Greyd0ve/nuedc_21f_car_mspm0/tmp/pdfs/ir8-pin-audit/schematic-3.png

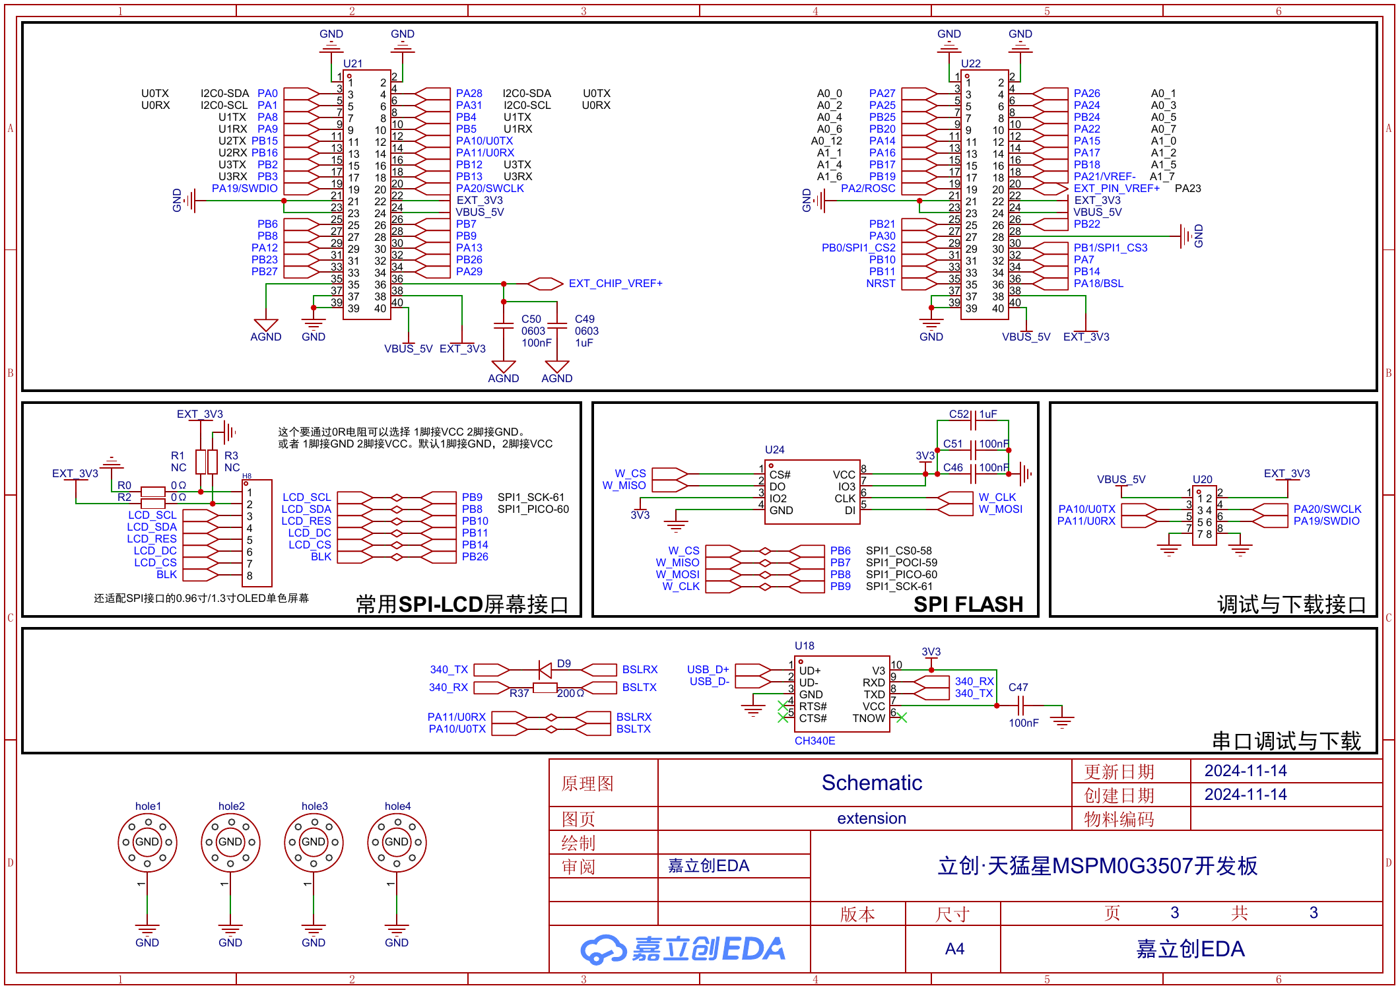
tmp/pdfs/ir8-pin-audit/schematic-3.png
