Greyd0ve/nuedc_21f_car_mspm0/firmware_withoutK230/master_car/keil/build_output.txt

Clean started: Project: 'empty_LP_MSPM0G3507_nortos_keil'
   deleting intermediate output files for target 'master_car_withoutK230'
Clean done
Build started: Project: empty_LP_MSPM0G3507_nortos_keil
*** Using Compiler 'V6.21', folder: 'D:\Keil_v5_38a\ARM\ARMCLANG\Bin'
Build target 'master_car_withoutK230'
Before Build - User command #1: cmd.exe /C ""C:\ti\sysconfig_1.21.1\sysconfig_cli.bat" -o "C:\Users\zch20\Desktop\Myproject\Github�ֿ�\nuedc_21f_car_mspm0\firmware_withoutK230\master_car\keil\.." -s "D:\ti2\mspm0_sdk_2_02_00_05\.metadata\product.json" --compiler keil "C:\Users\zch20\Desktop\Myproject\Github�ֿ�\nuedc_21f_car_mspm0\firmware_withoutK230\master_car\keil\..\empty.syscfg""
Running script...
Validating...
info: PWM_SERVO(/ti/driverlib/PWM): Peripheral does not retain register contents in STOP or STANDBY modes. User should take care to save and restore register configuration in application. See Retention Configuration section for more details.
info: TIMER_SYS(/ti/driverlib/TIMER): Peripheral does not retain register contents in STOP or STANDBY modes. User should take care to save and restore register configuration in application. See Retention Configuration section for more details.
Generating Code (empty.syscfg)...
Unchanged C:\Users\zch20\Desktop\Myproject\Github仓库\nuedc_21f_car_mspm0\firmware_withoutK230\master_car\ti_msp_dl_config.c...
Unchanged C:\Users\zch20\Desktop\Myproject\Github仓库\nuedc_21f_car_mspm0\firmware_withoutK230\master_car\ti_msp_dl_config.h...
Unchanged C:\Users\zch20\Desktop\Myproject\Github仓库\nuedc_21f_car_mspm0\firmware_withoutK230\master_car\Event.dot...
compiling app_task_mode.c...
compiling app_line.c...
compiling pid.c...
assembling startup_mspm0g350x_uvision.s...
compiling app_radio.c...
compiling app_control.c...
compiling app_car_base.c...
compiling main.c...
compiling Motor.c...
compiling app_car_state.c...
compiling PWM.c...
compiling app_board_test.c...
compiling Encoder.c...
compiling ti_msp_dl_config.c...
compiling app_21f_car.c...
compiling Key.c...
compiling Grayscale.c...
compiling app_coop.c...
compiling DebugSerial.c...
compiling Serial.c...
compiling Servo.c...
compiling BeepLed.c...
compiling OLED.c...
compiling StepperEncoder.c...
compiling JY61P.c...
compiling NRF24L01.c...
compiling Timer.c...
linking...
Program Size: Code=18916 RO-data=1372 RW-data=16 ZI-data=3216  
FromELF: creating hex file...
".\Objects\master_car_withoutK230.axf" - 0 Error(s), 0 Warning(s).
Build Time Elapsed:  00:00:02
