Greyd0ve/nuedc_21f_car_mspm0/tmp/pdfs/h_problem_3.png

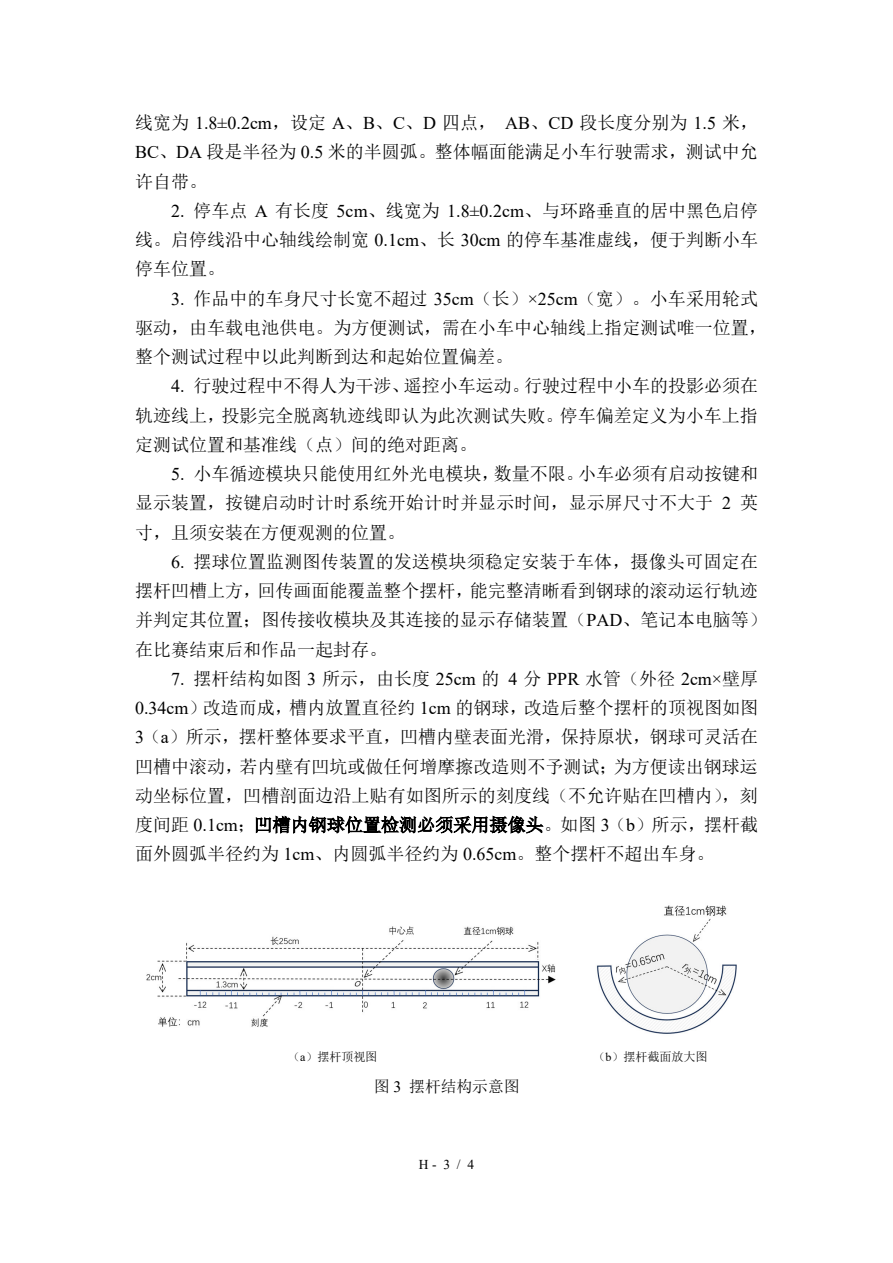
tmp/pdfs/h_problem_3.png
