Greyd0ve/nuedc_21f_car_mspm0/firmware_withK230/master_car/Hardware/Board_Config.h

#ifndef __BOARD_CONFIG_H
#define __BOARD_CONFIG_H

#include "ti_msp_dl_config.h"

/*
 * Board pin map for the MSPM0G3507 car wiring.
 *
 * Keep application code using these names.  SysConfig-generated names stay
 * below this file and can be changed without touching App/Control logic.
 */

/*
 * ECAR_REAR_LINE_SENSOR_MODE:
 *   0 = original front sensor module layout;
 *   1 = rear-facing sensor/camera layout.  The camera view defines the new
 *       vehicle front, so the vehicle coordinate frame is rotated 180 deg.
 *       Original right wheel becomes logical left wheel and original left
 *       wheel becomes logical right wheel; positive logical wheel speed
 *       drives the vehicle toward the camera-view forward direction.
 */
#ifndef ECAR_REAR_LINE_SENSOR_MODE
#define ECAR_REAR_LINE_SENSOR_MODE 1U
#endif

/*
 * The eight-channel infrared module is mounted in front of the drive-wheel
 * axle.  This setting affects only infrared channel order and line-control
 * sign; it deliberately does not alter the verified motor/encoder mapping
 * selected by ECAR_REAR_LINE_SENSOR_MODE above.
 */
#ifndef ECAR_LINE_SENSOR_FORWARD_MOUNT
#define ECAR_LINE_SENSOR_FORWARD_MOUNT 1U
#endif

/* Compatibility aliases for SysConfig-generated grouped GPIO names. */
#if !defined(GPIO_I2C0_SCL_PORT) && defined(GPIO_I2C_SHARED_SCL_PORT)
#define GPIO_I2C0_SCL_PORT              GPIO_I2C_SHARED_SCL_PORT
#define GPIO_I2C0_SCL_PIN               GPIO_I2C_SHARED_SCL_PIN
#define GPIO_I2C0_SDA_PORT              GPIO_I2C_SHARED_SDA_PORT
#define GPIO_I2C0_SDA_PIN               GPIO_I2C_SHARED_SDA_PIN
#endif

#if !defined(GPIO_IR8_X1_PORT) && defined(GPIO_IR8_PORT)
#define GPIO_IR8_X1_PORT                GPIO_IR8_PORT
#define GPIO_IR8_X2_PORT                GPIO_IR8_PORT
#define GPIO_IR8_X3_PORT                GPIO_IR8_PORT
#define GPIO_IR8_X4_PORT                GPIO_IR8_PORT
#define GPIO_IR8_X5_PORT                GPIO_IR8_PORT
#define GPIO_IR8_X6_PORT                GPIO_IR8_PORT
#define GPIO_IR8_X7_PORT                GPIO_IR8_PORT
#define GPIO_IR8_X8_PORT                GPIO_IR8_PORT
#endif

#if !defined(GPIO_KEYS_KEY1_PORT) && defined(GPIO_KEYS_PORT)
#define GPIO_KEYS_KEY1_PORT             GPIO_KEYS_PORT
#define GPIO_KEYS_KEY2_PORT             GPIO_KEYS_PORT
#define GPIO_KEYS_KEY3_PORT             GPIO_KEYS_PORT
#define GPIO_KEYS_KEY4_PORT             GPIO_KEYS_PORT
#endif

#if !defined(GPIO_BEEP_PORT)
#if defined(GPIO_BOARD_IO_BEEP_PORT)
#define GPIO_BEEP_PORT                  GPIO_BOARD_IO_BEEP_PORT
#elif defined(GPIO_BOARD_IO_PORT)
#define GPIO_BEEP_PORT                  GPIO_BOARD_IO_PORT
#endif
#endif

#if !defined(GPIO_BEEP_PIN) && defined(GPIO_BOARD_IO_BEEP_PIN)
#define GPIO_BEEP_PIN                   GPIO_BOARD_IO_BEEP_PIN
#endif

#if !defined(GPIO_BEEP_IOMUX) && defined(GPIO_BOARD_IO_BEEP_IOMUX)
#define GPIO_BEEP_IOMUX                 GPIO_BOARD_IO_BEEP_IOMUX
#endif

#if !defined(GPIO_ENCODER_L_A_PORT) && defined(GPIO_ENCODER_PORT)
#define GPIO_ENCODER_L_A_PORT           GPIO_ENCODER_PORT
#define GPIO_ENCODER_L_B_PORT           GPIO_ENCODER_PORT
#define GPIO_ENCODER_R_A_PORT           GPIO_ENCODER_PORT
#define GPIO_ENCODER_R_B_PORT           GPIO_ENCODER_PORT
#endif

#if !defined(GPIO_ENCODER_INT_IRQN) && defined(GPIO_ENCODER_GPIOA_INT_IRQN)
#define GPIO_ENCODER_INT_IRQN           GPIO_ENCODER_GPIOA_INT_IRQN
#elif !defined(GPIO_ENCODER_INT_IRQN) && defined(GPIO_ENCODER_GPIOB_INT_IRQN)
#define GPIO_ENCODER_INT_IRQN           GPIO_ENCODER_GPIOB_INT_IRQN
#endif

/* Project hardware abstraction: encoder interrupt IRQ number.
 * Encoder.c must use ECAR_ENCODER_IRQN, never a raw SysConfig macro. */
#ifdef GPIO_ENCODER_INT_IRQN
#define ECAR_ENCODER_IRQN               GPIO_ENCODER_INT_IRQN
#else
#error "GPIO_ENCODER_INT_IRQN not generated by SysConfig. Check empty.syscfg encoder GPIO interruptEn setting."
#endif

/* ---------------- TB6612 motor driver ----------------
 * PWMA -> TIMG0-C0, PWMB -> TIMG0-C1.
 * STBY is tied to 5V on the current PCB.  There is no MCU STBY control.
 */
#define MOTOR_USE_STBY                  0U
#define MOTOR_STBY_TIED_TO_5V           1U
#define MOTOR_PWM_TIMER_INST            PWM_MOTOR_INST

#if ECAR_REAR_LINE_SENSOR_MODE

/* Rear sensor / reversed heading mode:
 * original right wheel is logical left wheel;
 * original left wheel is logical right wheel.
 */
#define MOTOR_L_PWM_CC_INDEX            GPIO_PWM_MOTOR_C1_IDX
#define MOTOR_R_PWM_CC_INDEX            GPIO_PWM_MOTOR_C0_IDX

#define MOTOR_L_IN1_PORT                GPIO_MOTOR_R_IN1_PORT   /* PA16 */
#define MOTOR_L_IN1_PIN                 GPIO_MOTOR_R_IN1_PIN
#define MOTOR_L_IN1                     MOTOR_L_IN1_PIN
#define MOTOR_L_IN2_PORT                GPIO_MOTOR_R_IN2_PORT   /* B24 */
#define MOTOR_L_IN2_PIN                 GPIO_MOTOR_R_IN2_PIN
#define MOTOR_L_IN2                     MOTOR_L_IN2_PIN
#define MOTOR_R_IN1_PORT                GPIO_MOTOR_L_IN1_PORT   /* B17 */
#define MOTOR_R_IN1_PIN                 GPIO_MOTOR_L_IN1_PIN
#define MOTOR_R_IN1                     MOTOR_R_IN1_PIN
#define MOTOR_R_IN2_PORT                GPIO_MOTOR_L_IN2_PORT   /* B19 */
#define MOTOR_R_IN2_PIN                 GPIO_MOTOR_L_IN2_PIN
#define MOTOR_R_IN2                     MOTOR_R_IN2_PIN

/*
 * The wheel test showed that the old signs made positive logical PWM drive
 * both wheels backward.  These signs make Motor_SetPWM(+150, +150) drive
 * toward the camera-view forward direction.
 */
#define LEFT_MOTOR_DIR                  (+1)
#define RIGHT_MOTOR_DIR                 (-1)

#else

/* Original front sensor mode. */
#define MOTOR_L_PWM_CC_INDEX            GPIO_PWM_MOTOR_C0_IDX
#define MOTOR_R_PWM_CC_INDEX            GPIO_PWM_MOTOR_C1_IDX

#define MOTOR_L_IN1_PORT                GPIO_MOTOR_L_IN1_PORT   /* B17 */
#define MOTOR_L_IN1_PIN                 GPIO_MOTOR_L_IN1_PIN
#define MOTOR_L_IN1                     MOTOR_L_IN1_PIN
#define MOTOR_L_IN2_PORT                GPIO_MOTOR_L_IN2_PORT   /* B19 */
#define MOTOR_L_IN2_PIN                 GPIO_MOTOR_L_IN2_PIN
#define MOTOR_L_IN2                     MOTOR_L_IN2_PIN
#define MOTOR_R_IN1_PORT                GPIO_MOTOR_R_IN1_PORT   /* A16 */
#define MOTOR_R_IN1_PIN                 GPIO_MOTOR_R_IN1_PIN
#define MOTOR_R_IN1                     MOTOR_R_IN1_PIN
#define MOTOR_R_IN2_PORT                GPIO_MOTOR_R_IN2_PORT   /* B24 */
#define MOTOR_R_IN2_PIN                 GPIO_MOTOR_R_IN2_PIN
#define MOTOR_R_IN2                     MOTOR_R_IN2_PIN

#define LEFT_MOTOR_DIR                  (+1)
#define RIGHT_MOTOR_DIR                 (-1)

#endif

#define MOTOR_L_PWM                     MOTOR_L_PWM_CC_INDEX
#define MOTOR_R_PWM                     MOTOR_R_PWM_CC_INDEX
#define MOTOR_PWM_LEFT_CC_INDEX         MOTOR_L_PWM_CC_INDEX
#define MOTOR_PWM_RIGHT_CC_INDEX        MOTOR_R_PWM_CC_INDEX
#define MOTOR_PWM_PERIOD_COUNTS         1600U

/* Legacy aliases kept for older modules during transition. */
#define MOTOR_AIN1_PORT                 MOTOR_L_IN1_PORT
#define MOTOR_AIN1_PIN                  MOTOR_L_IN1_PIN
#define MOTOR_AIN2_PORT                 MOTOR_L_IN2_PORT
#define MOTOR_AIN2_PIN                  MOTOR_L_IN2_PIN
#define MOTOR_BIN1_PORT                 MOTOR_R_IN1_PORT
#define MOTOR_BIN1_PIN                  MOTOR_R_IN1_PIN
#define MOTOR_BIN2_PORT                 MOTOR_R_IN2_PORT
#define MOTOR_BIN2_PIN                  MOTOR_R_IN2_PIN

#define LEFT_MOTOR_DIR_SIGN             LEFT_MOTOR_DIR
#define RIGHT_MOTOR_DIR_SIGN            RIGHT_MOTOR_DIR

/* ---------------- Encoders ----------------
 * First version uses A-phase GPIO interrupt and B-phase level sampling.
 * ENC_L_A -> PA26, ENC_L_B -> PA27
 * ENC_R_A -> PA25, ENC_R_B -> PA14
 * A phases are on GPIOA, so GROUP1 GPIOA dispatch handles both counters.
 */
#if ECAR_REAR_LINE_SENSOR_MODE

/* Rear sensor / reversed heading mode:
 * original right encoder is logical left encoder;
 * original left encoder is logical right encoder.
 */
#define ENC_L_A_PORT                    GPIO_ENCODER_R_A_PORT
#define ENC_L_A_PIN                     GPIO_ENCODER_R_A_PIN
#define ENC_L_B_PORT                    GPIO_ENCODER_R_B_PORT
#define ENC_L_B_PIN                     GPIO_ENCODER_R_B_PIN
#define ENC_R_A_PORT                    GPIO_ENCODER_L_A_PORT
#define ENC_R_A_PIN                     GPIO_ENCODER_L_A_PIN
#define ENC_R_B_PORT                    GPIO_ENCODER_L_B_PORT
#define ENC_R_B_PIN                     GPIO_ENCODER_L_B_PIN

/*
 * The motor polarity above was inverted after the wheel test.  Keep the
 * encoder signs paired with it so travel toward the camera-view front
 * produces positive logical wheel speed.
 * Verify:
 * g_leftEncoderDelta > 0, g_rightEncoderDelta > 0,
 * g_forwardEncoderTotal increases.
 */
#define LEFT_ENCODER_DIR                (-1)
#define RIGHT_ENCODER_DIR               (+1)

#else

/* Original front sensor mode. */
#define ENC_L_A_PORT                    GPIO_ENCODER_L_A_PORT
#define ENC_L_A_PIN                     GPIO_ENCODER_L_A_PIN
#define ENC_L_B_PORT                    GPIO_ENCODER_L_B_PORT
#define ENC_L_B_PIN                     GPIO_ENCODER_L_B_PIN
#define ENC_R_A_PORT                    GPIO_ENCODER_R_A_PORT
#define ENC_R_A_PIN                     GPIO_ENCODER_R_A_PIN
#define ENC_R_B_PORT                    GPIO_ENCODER_R_B_PORT
#define ENC_R_B_PIN                     GPIO_ENCODER_R_B_PIN

#define LEFT_ENCODER_DIR                (-1)
#define RIGHT_ENCODER_DIR               (+1)

#endif

#define ENC_L_A                         ENC_L_A_PIN
#define ENC_L_B                         ENC_L_B_PIN
#define ENC_R_A                         ENC_R_A_PIN
#define ENC_R_B                         ENC_R_B_PIN

#define ENCODER_LEFT_A_PORT             ENC_L_A_PORT
#define ENCODER_LEFT_A_PIN              ENC_L_A_PIN
#define ENCODER_LEFT_B_PORT             ENC_L_B_PORT
#define ENCODER_LEFT_B_PIN              ENC_L_B_PIN
#define ENCODER_RIGHT_A_PORT            ENC_R_A_PORT
#define ENCODER_RIGHT_A_PIN             ENC_R_A_PIN
#define ENCODER_RIGHT_B_PORT            ENC_R_B_PORT
#define ENCODER_RIGHT_B_PIN             ENC_R_B_PIN

#define LEFT_ENCODER_SIGN               LEFT_ENCODER_DIR
#define RIGHT_ENCODER_SIGN              RIGHT_ENCODER_DIR

/* ---------------- 8-channel infrared line sensor ----------------
 * Direct input wiring, from physical left X1 to physical right X8:
 * X1 -> PB23, X2 -> PB11, X3 -> PB13, X4 -> PB01,
 * X5 -> PB14, X6 -> PB04, X7 -> PA22, X8 -> PA15.
 *
 * PB04 is deliberately removed from the user-LED function.  PA22 and PA15
 * are deliberately removed from servo PWM.  Every X output must be <= 3.3V.
 */
#define IR8_X1_PORT                     GPIO_IR8_X1_PORT
#define IR8_X1_PIN                      GPIO_IR8_X1_PIN
#define IR8_X2_PORT                     GPIO_IR8_X2_PORT
#define IR8_X2_PIN                      GPIO_IR8_X2_PIN
#define IR8_X3_PORT                     GPIO_IR8_X3_PORT
#define IR8_X3_PIN                      GPIO_IR8_X3_PIN
#define IR8_X4_PORT                     GPIO_IR8_X4_PORT
#define IR8_X4_PIN                      GPIO_IR8_X4_PIN
#define IR8_X5_PORT                     GPIO_IR8_X5_PORT
#define IR8_X5_PIN                      GPIO_IR8_X5_PIN
#define IR8_X6_PORT                     GPIO_IR8_X6_PORT
#define IR8_X6_PIN                      GPIO_IR8_X6_PIN
#define IR8_X7_PORT                     GPIO_IR8_X7_PORT
#define IR8_X7_PIN                      GPIO_IR8_X7_PIN
#define IR8_X8_PORT                     GPIO_IR8_X8_PORT
#define IR8_X8_PIN                      GPIO_IR8_X8_PIN

/* ---------------- I2C0 shared bus ----------------
 * Use 3.3V power and pull SDA/SCL up to 3.3V.  Do not pull I2C to 5V.
 * MPU6050 I2C0-SDA -> PA28
 * MPU6050 I2C0-SCL -> PA31
 */
#define I2C0_SCL_PORT                   GPIO_I2C0_SCL_PORT
#define I2C0_SCL_PIN                    GPIO_I2C0_SCL_PIN
#define I2C0_SCL                        I2C0_SCL_PIN
#define I2C0_SDA_PORT                   GPIO_I2C0_SDA_PORT
#define I2C0_SDA_PIN                    GPIO_I2C0_SDA_PIN
#define I2C0_SDA                        I2C0_SDA_PIN
#define BOARD_I2C0_INST                 I2C_SHARED_INST
#define BOARD_I2C0_BUS_SPEED_HZ         I2C_SHARED_BUS_SPEED_HZ

#define OLED_I2C_INST                   BOARD_I2C0_INST
#define OLED_I2C_BUS_SPEED_HZ           BOARD_I2C0_BUS_SPEED_HZ
#define OLED_I2C_SCL_PORT               I2C0_SCL_PORT
#define OLED_I2C_SCL_PIN                I2C0_SCL_PIN
#define OLED_I2C_SDA_PORT               I2C0_SDA_PORT
#define OLED_I2C_SDA_PIN                I2C0_SDA_PIN
#define MPU6050_I2C_INST                BOARD_I2C0_INST

/* ---------------- Tianmengxing H8 OLED header ----------------
 * Tianmengxing H8 1x8 display header:
 * H8-1 GND, H8-2 3V3, H8-3 SCL/PB9, H8-4 SDA/PB8,
 * H8-5 RES/PB10, H8-6 DC/PB11, H8-7 CS/PB14.
 *
 * Current display wiring is a 4-pin IIC OLED plugged into H8 first 4 pins:
 * GND, VCC, SCL/SKC, SDA -> PB9/PB8 through software I2C.
 *
 * H8 IIC mode only uses PB9/PB8. H8 SPI mode also takes PB10/PB11/PB14,
 * conflicting with IR8 X2/PB11 and X5/PB14.  SPI OLED must stay disabled.
 */
#ifndef BOARD_OLED_USE_H8_I2C
#define BOARD_OLED_USE_H8_I2C           1U
#endif
#ifndef BOARD_OLED_USE_H8_SPI
#define BOARD_OLED_USE_H8_SPI           0U
#endif
#if BOARD_OLED_USE_H8_I2C && BOARD_OLED_USE_H8_SPI
#error "Choose either H8 I2C OLED or H8 SPI OLED, not both."
#endif
#define BOARD_OLED_H8_SPI_CONFLICTS_IR8 BOARD_OLED_USE_H8_SPI
#define BOARD_OLED_H8_SPI_OWNS_KEY12    BOARD_OLED_USE_H8_SPI

#define OLED_H8_PORT                    GPIOB
#define OLED_H8_SCL_PIN                 DL_GPIO_PIN_9    /* H8-3, SCL/SCK */
#define OLED_H8_SCL_IOMUX               IOMUX_PINCM26
#define OLED_H8_SDA_PIN                 DL_GPIO_PIN_8    /* H8-4, SDA/MOSI */
#define OLED_H8_SDA_IOMUX               IOMUX_PINCM25
#define OLED_H8_RES_PIN                 DL_GPIO_PIN_10   /* H8-5 */
#define OLED_H8_RES_IOMUX               IOMUX_PINCM27
#define OLED_H8_DC_PIN                  DL_GPIO_PIN_11   /* H8-6 */
#define OLED_H8_DC_IOMUX                IOMUX_PINCM28
#define OLED_H8_CS_PIN                  DL_GPIO_PIN_14   /* H8-7 */
#define OLED_H8_CS_IOMUX                IOMUX_PINCM31
#define OLED_H8_PIN_MASK                (OLED_H8_SCL_PIN | OLED_H8_SDA_PIN | \
                                         OLED_H8_RES_PIN | OLED_H8_DC_PIN | \
                                         OLED_H8_CS_PIN)

/* ---------------- Beeper and released user-LED pin ---------------- */
#define BEEP_PORT                       GPIO_BEEP_PORT       /* A07 */
#define BEEP_PIN                        GPIO_BEEP_PIN
#define BEEP                            BEEP_PIN
#define BOARD_USER_LED_ENABLE           0U

/* ---------------- Keys, active low with internal pull-up ---------------- */
#define KEY1_PORT                       GPIO_KEYS_KEY1_PORT  /* PB22 / K1 */
#define KEY1_PIN                        GPIO_KEYS_KEY1_PIN
#define KEY1                            KEY1_PIN
#define KEY2_PORT                       GPIO_KEYS_KEY2_PORT  /* PA30 / K2 */
#define KEY2_PIN                        GPIO_KEYS_KEY2_PIN
#define KEY2                            KEY2_PIN
#define KEY3_PORT                       GPIO_KEYS_KEY3_PORT  /* PB27 / K3 */
#define KEY3_PIN                        GPIO_KEYS_KEY3_PIN
#define KEY3                            KEY3_PIN
#define KEY4_PORT                       GPIO_KEYS_KEY4_PORT  /* PA29 / K4 */
#define KEY4_PIN                        GPIO_KEYS_KEY4_PIN
#define KEY4                            KEY4_PIN

#define KEY_K1_PORT                     KEY1_PORT
#define KEY_K1_PIN                      KEY1_PIN
#define KEY_K2_PORT                     KEY2_PORT
#define KEY_K2_PIN                      KEY2_PIN
#define KEY_K3_PORT                     KEY3_PORT
#define KEY_K3_PIN                      KEY3_PIN
#define KEY_K4_PORT                     KEY4_PORT
#define KEY_K4_PIN                      KEY4_PIN

/* ---------------- Rod ball stepper ----------------
 * STEP: PA02 / TIMG7-C1 hardware PWM.  PA02 is also the ROSC pin on this
 * board, so SYSCTL FCL/ROSC calibration must remain disabled.
 * DIR: PB25 GPIO output.  EN: PB21 GPIO output, active low and held low.
 * Encoder A/B: PB00/PB18 GPIOB dual-edge interrupts, decoded in RodEncoder.
 */
#define ROD_STEP_TIMER_INST              PWM_ROD_STEP_INST
#define ROD_STEP_TIMER_IRQN              PWM_ROD_STEP_INST_INT_IRQN
#define ROD_STEP_TIMER_CLK_HZ            PWM_ROD_STEP_INST_CLK_FREQ
#define ROD_STEP_CC_INDEX                GPIO_PWM_ROD_STEP_C1_IDX
#define ROD_STEP_PORT                    GPIO_PWM_ROD_STEP_C1_PORT
#define ROD_STEP_PIN                     GPIO_PWM_ROD_STEP_C1_PIN
#define ROD_STEP_IOMUX                   GPIO_PWM_ROD_STEP_C1_IOMUX
#define ROD_STEP_IOMUX_FUNC              GPIO_PWM_ROD_STEP_C1_IOMUX_FUNC

#define ROD_DIR_PORT                     GPIO_ROD_STEPPER_PORT
#define ROD_DIR_PIN                      GPIO_ROD_STEPPER_ROD_DIR_PIN
#define ROD_DIR_IOMUX                    GPIO_ROD_STEPPER_ROD_DIR_IOMUX

#define ROD_EN_PORT                      GPIO_ROD_STEPPER_PORT
#define ROD_EN_PIN                       GPIO_ROD_STEPPER_ROD_EN_PIN
#define ROD_EN_IOMUX                     GPIO_ROD_STEPPER_ROD_EN_IOMUX
#define ROD_EN_ACTIVE_LEVEL              0U

#define ROD_ENCODER_A_PORT               GPIO_ROD_ENCODER_PORT
#define ROD_ENCODER_A_PIN                GPIO_ROD_ENCODER_ROD_ENC_A_PIN
#define ROD_ENCODER_A_IOMUX              GPIO_ROD_ENCODER_ROD_ENC_A_IOMUX
#define ROD_ENCODER_B_PORT               GPIO_ROD_ENCODER_PORT
#define ROD_ENCODER_B_PIN                GPIO_ROD_ENCODER_ROD_ENC_B_PIN
#define ROD_ENCODER_B_IOMUX              GPIO_ROD_ENCODER_ROD_ENC_B_IOMUX
#define ROD_ENCODER_IRQN                 GPIO_ROD_ENCODER_INT_IRQN

/* ---------------- UARTs ----------------
 * UART_DEBUG  = UART0, PA0/TX and PA1/RX, 9600, for USB-TTL diagnostics.
 * UART_K230   = UART1, PB6/TX and PB7/RX, 460800, for K230 vision.
 * Connect TX to the peer's RX and share a 3.3 V logic ground. Do not send
 * DebugSerial output over UART1: it would corrupt the K230 binary protocol.
 * UART_JY61P  = UART2, PA23/PA24, 9600  for JY61P IMU.
 */
#define SERIAL_UART_INST                UART_K230_INST
#define SERIAL_UART_IRQN                UART_K230_INST_INT_IRQN
#define SERIAL_BAUD_RATE                UART_K230_BAUD_RATE

#define JY61P_UART_INST                 UART_JY61P_INST
#define JY61P_UART_IRQN                 UART_JY61P_INST_INT_IRQN
#define JY61P_UART_BAUD_RATE            UART_JY61P_BAUD_RATE
#define JY61P_UART_IRQHandler           UART_JY61P_INST_IRQHandler

/* ---------------- System tick ---------------- */
#define SYSTEM_TIMER_INST               TIMER_SYS_INST
#define SYSTEM_TIMER_IRQN               TIMER_SYS_INST_INT_IRQN

/*
 * SWDIO/SWCLK are not configured as GPIO here.  Future hardware should route
 * RST to the SWD connector.
 *
 * Reserved headers:
 * H1: B05, B15, A10, B16, A11, B12.  B05 is a future TB6612_STBY candidate.
 * H3: B25, B18, B21, B22, A30, B00.
 */

#endif
