Greyd0ve/nuedc_21f_car_mspm0/firmware_withK230/master_car/App/app_config.h

#ifndef __APP_CONFIG_H
#define __APP_CONFIG_H

#include <stdint.h>

/* Run the H26 task manager with the direct eight-channel infrared sensor. */
#ifndef APP_MODE_H26
#define APP_MODE_H26                         1U
#endif

/*
 * All ECAR_* test macros MUST be defined (with #ifndef guard) before any
 * #if check that references them.  Undefined identifiers in #if evaluate
 * to 0, silently disabling the mutual-exclusion error.
 */

/* Temporary encoder-only memory corruption diagnostic mode. */
#ifndef ECAR_ENCODER_MINIMAL_DEBUG
#define ECAR_ENCODER_MINIMAL_DEBUG              0
#endif

/* Master board test toggle.  0 = normal task mode, 1 = board test mode. */
#ifndef ECAR_BOARD_TEST_MODE
#define ECAR_BOARD_TEST_MODE                    0U
#endif

/*
 * Board test sub-mode enables.
 *
 * To run the eight-channel IR board test, set both values to 1:
 *   ECAR_BOARD_TEST_MODE = 1U
 *   ECAR_TEST_IR8_ENABLE = 1U
 * Board-test mode has priority over APP_MODE_H26 and keeps both motors stopped.
 */
#ifndef ECAR_TEST_IR8_ENABLE
#define ECAR_TEST_IR8_ENABLE                    0U
#endif
#ifndef ECAR_TEST_MOTOR_ENABLE
#define ECAR_TEST_MOTOR_ENABLE                  0
#endif
#ifndef ECAR_TEST_SPEED_PID_ENABLE
#define ECAR_TEST_SPEED_PID_ENABLE              0U
#endif
#ifndef ECAR_TEST_BEEP_ENABLE
#define ECAR_TEST_BEEP_ENABLE                   0
#endif
#ifndef ECAR_TEST_OLED_ENABLE
#define ECAR_TEST_OLED_ENABLE                   0
#endif
#ifndef ECAR_TEST_RADIO_ENABLE
#define ECAR_TEST_RADIO_ENABLE                  0
#endif
#ifndef ECAR_TEST_STEPPER_ENCODER_ENABLE
#define ECAR_TEST_STEPPER_ENCODER_ENABLE        0
#endif
#ifndef ECAR_TEST_ROD_STEPPER_ENABLE
#define ECAR_TEST_ROD_STEPPER_ENABLE            0U
#endif
#ifndef ECAR_TEST_JY61P_ENABLE
#define ECAR_TEST_JY61P_ENABLE                  0
#endif
#ifndef JY61P_AUTO_ZERO_ON_FIRST_VALID
#define JY61P_AUTO_ZERO_ON_FIRST_VALID          0
#endif

/* Mutual exclusion: only one board test sub-mode at a time. */
#if ((ECAR_TEST_IR8_ENABLE + \
      ECAR_TEST_MOTOR_ENABLE + \
      ECAR_TEST_SPEED_PID_ENABLE + \
      ECAR_TEST_BEEP_ENABLE + \
      ECAR_TEST_OLED_ENABLE + \
      ECAR_TEST_RADIO_ENABLE + \
      ECAR_TEST_STEPPER_ENCODER_ENABLE + \
      ECAR_TEST_ROD_STEPPER_ENABLE + \
      ECAR_TEST_JY61P_ENABLE) > 1)
#error "Only one board test sub-mode can be enabled at a time"
#endif

/*
 * Stepper encoder measured parameters.
 *
 * ECAR_STEPPER_ENCODER_CPR (4096):
 *   After AB quadrature 4x decoding, one mechanical axis revolution
 *   produces 4096 feedback counts.
 *
 * ECAR_STEPPER_DRIVER_PULSE_PER_REV (3200):
 *   Under the driver's standard microstep setting, sending 3200 STEP
 *   pulses causes one theoretical motor revolution.
 *
 * These two are DIFFERENT pulse types.  The ratio is:
 *   4096 / 3200 = 32 / 25
 * Do NOT set ECAR_STEPPER_ENCODER_CPR to 3200.
 */
#define ECAR_STEPPER_ENCODER_CPR                4096U
#define ECAR_STEPPER_DRIVER_PULSE_PER_REV       3200U

/* Neutral CAR_ aliases for template layer use.
 * ECAR_ macros are kept for backward compatibility with existing drivers. */
#define CAR_OLED_ENABLE                 ECAR_OLED_ENABLE
#define CAR_BOARD_TEST_MODE             ECAR_BOARD_TEST_MODE
#define CAR_TEST_IR8_ENABLE             ECAR_TEST_IR8_ENABLE
#define CAR_TEST_MOTOR_ENABLE           ECAR_TEST_MOTOR_ENABLE
#define CAR_TEST_SPEED_PID_ENABLE       ECAR_TEST_SPEED_PID_ENABLE
#define CAR_TEST_BEEP_ENABLE            ECAR_TEST_BEEP_ENABLE
#define CAR_TEST_OLED_ENABLE            ECAR_TEST_OLED_ENABLE
#define CAR_TEST_RADIO_ENABLE           ECAR_TEST_RADIO_ENABLE
#define CAR_TEST_STEPPER_ENCODER_ENABLE ECAR_TEST_STEPPER_ENCODER_ENABLE
#define CAR_TEST_ROD_STEPPER_ENABLE     ECAR_TEST_ROD_STEPPER_ENABLE
#define CAR_TEST_JY61P_ENABLE           ECAR_TEST_JY61P_ENABLE
#define CAR_ENCODER_MINIMAL_DEBUG       ECAR_ENCODER_MINIMAL_DEBUG
#define CAR_ENCODER_SPEED_PERIOD_MS     ECAR_ENCODER_SPEED_PERIOD_MS
#define CAR_CONTROL_PERIOD_MS           ECAR_CONTROL_PERIOD_MS
#define CAR_SERIAL_PLOT_PERIOD_MS       ECAR_SERIAL_PLOT_PERIOD_MS
#define CAR_OLED_REFRESH_PERIOD_MS      ECAR_OLED_REFRESH_PERIOD_MS
#define CAR_TASK_COUNT_MAX              ECAR_TASK_COUNT_MAX

/* CarBase template behaviour switches. */
#ifndef CAR_BASE_SERIAL_MONITOR_ENABLE
#define CAR_BASE_SERIAL_MONITOR_ENABLE          0
#endif
#ifndef CAR_BASE_BOOT_PROMPT_ENABLE
#define CAR_BASE_BOOT_PROMPT_ENABLE             0
#endif

#ifndef CAR_ROLE_MASTER
#define CAR_ROLE_MASTER                         1
#endif
#ifndef CAR_ROLE_SLAVE
#define CAR_ROLE_SLAVE                          0
#endif
#if ((CAR_ROLE_MASTER + CAR_ROLE_SLAVE) != 1)
#error "Exactly one radio role must be enabled"
#endif
#ifndef CAR_ID
#define CAR_ID                                  1
#endif
#ifndef ENABLE_K230
#define ENABLE_K230                             1
#endif

#ifndef RADIO_DEBUG_ENABLE
#define RADIO_DEBUG_ENABLE                      1
#endif

/* Master OLED switch. Set to 1 only when the display is physically connected.
 * When 0, all OLED_Init / OLED_Clear / status display calls are compiled out. */
#ifndef ECAR_OLED_ENABLE
#define ECAR_OLED_ENABLE                        1
#endif

/* Periodic task intervals driven by the 1ms timer ISR. */
#ifndef ECAR_TASK_COUNT_MAX
#define ECAR_TASK_COUNT_MAX                     5U
#endif
#define ECAR_ENCODER_SPEED_PERIOD_MS            5U
#define ECAR_CONTROL_PERIOD_MS                  10U
#define ECAR_SERIAL_PLOT_PERIOD_MS              100U
#define ECAR_OLED_REFRESH_PERIOD_MS             200U

/*
 * Nominal JGA25-370B + 65mm wheel conversion constants.
 * ECAR_ENCODER_PULSE_PER_REV is measured under Encoder.c default
 * A rising-edge counting mode. See app_config.h encoder comment.
 */
#define ECAR_PI_F                               3.1415926f
#define ECAR_WHEEL_DIAMETER_CM                 6.5f
#define ECAR_WHEEL_CIRCUMFERENCE_CM            (ECAR_WHEEL_DIAMETER_CM * ECAR_PI_F)

/*
 * Encoder counting mode:
 * - Current Encoder.c default counts only encoder A rising edges.
 * - Encoder B is sampled only for direction judgement.
 * - ECAR_ENCODER_PULSE_PER_REV is the measured wheel-end pulse count under
 *   this exact counting mode.
 *
 * If Encoder.c is changed to A both-edge counting or AB quadrature counting,
 * this value must be measured again.
 */
#define ECAR_ENCODER_PULSE_PER_REV             367.0f
#define ECAR_CM_PER_PULSE                      (ECAR_WHEEL_CIRCUMFERENCE_CM / ECAR_ENCODER_PULSE_PER_REV)

/* Nominal lap distance. */
#define ECAR_LAP_DISTANCE_CM                    400.0f

/*
 * Corner detection:
 * all-white (8-channel count == 0) for LOST_CONFIRM_MS triggers corner.
 */
#define ECAR_CORNER_ADVANCE_CM                  4.0f
#define ECAR_CORNER_MIN_STRAIGHT_CM             80.0f
#define ECAR_CORNER_LOST_CONFIRM_MS             100U
#define ECAR_LINE_LOST_FAULT_MS                 2500U

#define ECAR_CORNER_ADVANCE_PULSE \
    ((int32_t)(ECAR_CORNER_ADVANCE_CM / ECAR_CM_PER_PULSE + 0.5f))
#define ECAR_CORNER_MIN_STRAIGHT_PULSE \
    ((int32_t)(ECAR_CORNER_MIN_STRAIGHT_CM / ECAR_CM_PER_PULSE + 0.5f))

#define ECAR_DEFAULT_LAP_PULSE                  ((int32_t)((ECAR_LAP_DISTANCE_CM / ECAR_CM_PER_PULSE) + 0.5f))

/* Conservative first-run speed defaults, in cm/s. */
#define ECAR_DEFAULT_BASE_SPEED_CMPS            55.0f
#define ECAR_DEFAULT_RECOVER_SPEED_CMPS         10.0f
#define ECAR_DEFAULT_CORNER_FORWARD_CMPS        10.0f
#define ECAR_DEFAULT_CORNER_TURN_CMPS           12.0f
#define ECAR_DEFAULT_TURN_LIMIT_CMPS            8.0f

#ifndef ECAR_CORNER_CONFIRM_COUNT
#define ECAR_CORNER_CONFIRM_COUNT               2U
#endif
#ifndef ECAR_BOARD_TEST_PWM_LIMIT
#define ECAR_BOARD_TEST_PWM_LIMIT               260
#endif

/*
 * Independent K230 vision tracking mode.
 * When enabled, the main loop runs only the K230 vision link and
 * vision tracking controller.
 */
#ifndef ECAR_VISION_TRACK_MODE
#define ECAR_VISION_TRACK_MODE                  0
#endif

/*
 * Top-level execution mode mutual exclusion.
 * Board test deliberately overrides APP_MODE_H26, so the two may both be 1.
 */
#if ECAR_BOARD_TEST_MODE
#if (ECAR_ENCODER_MINIMAL_DEBUG || ECAR_VISION_TRACK_MODE)
#error "Board-test mode cannot be combined with encoder-debug or vision-track mode"
#endif
#elif ((ECAR_ENCODER_MINIMAL_DEBUG + \
        ECAR_VISION_TRACK_MODE + \
        APP_MODE_H26) > 1)
#error "Only one top-level execution mode can be enabled"
#endif

#endif
