Greyd0ve/nuedc_21f_car_mspm0/firmware_withK230/slave_car/App/app_h26_config.h

#ifndef __APP_H26_CONFIG_H
#define __APP_H26_CONFIG_H

#include "app_config.h"

/* H26 task-2 control and confirmation parameters.  Calibrate on the real track. */
#define H26_T2_BASE_SPEED_CMPS             25.0f
#define H26_T2_TURN_LIMIT_CMPS              6.0f

#define H26_T2_LEAVE_DISTANCE_CM            15.0f
#define H26_T2_LEAVE_LINE_STABLE_MS         80U

/* These are only false-trigger guards; the four-black-channel rule is final. */
#define H26_T2_MIN_FINISH_DISTANCE_CM      500.0f
#define H26_T2_MIN_FINISH_TIME_MS        10000U
#define H26_T2_MAX_RUN_TIME_MS           30000U

#define H26_T2_FINISH_BLACK_CHANNELS        4U
#define H26_T2_FINISH_HOLD_MS               30U

#define H26_T2_STOP_SPEED_CMPS               1.0f
#define H26_T2_STOP_HOLD_MS                 100U

/* Reuse the established line-loss strategy and escalate only after its timeout. */
#define H26_T2_LINE_LOST_FAULT_MS     ECAR_LINE_LOST_FAULT_MS

#define H26_LED_SHOW_ON_MS                 200U
#define H26_LED_SHOW_OFF_MS                200U
#define H26_LED_FINISHED_TOGGLE_MS         500U
#define H26_LED_FAULT_TOGGLE_MS            100U

#define H26_DEBUG_PERIOD_MS                500U

#endif
