Greyd0ve/nuedc_21f_car_mspm0/firmware_withK230/master_car/ti_msp_dl_config.c

/*
 * Copyright (c) 2023, Texas Instruments Incorporated
 * All rights reserved.
 *
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
 * *  Redistributions of source code must retain the above copyright
 *    notice, this list of conditions and the following disclaimer.
 *
 * *  Redistributions in binary form must reproduce the above copyright
 *    notice, this list of conditions and the following disclaimer in the
 *    documentation and/or other materials provided with the distribution.
 *
 * *  Neither the name of Texas Instruments Incorporated nor the names of
 *    its contributors may be used to endorse or promote products derived
 *    from this software without specific prior written permission.
 *
 * THIS SOFTWARE IS PROVIDED BY THE COPYRIGHT HOLDERS AND CONTRIBUTORS "AS IS"
 * AND ANY EXPRESS OR IMPLIED WARRANTIES, INCLUDING, BUT NOT LIMITED TO,
 * THE IMPLIED WARRANTIES OF MERCHANTABILITY AND FITNESS FOR A PARTICULAR
 * PURPOSE ARE DISCLAIMED. IN NO EVENT SHALL THE COPYRIGHT OWNER OR
 * CONTRIBUTORS BE LIABLE FOR ANY DIRECT, INDIRECT, INCIDENTAL, SPECIAL,
 * EXEMPLARY, OR CONSEQUENTIAL DAMAGES (INCLUDING, BUT NOT LIMITED TO,
 * PROCUREMENT OF SUBSTITUTE GOODS OR SERVICES; LOSS OF USE, DATA, OR PROFITS;
 * OR BUSINESS INTERRUPTION) HOWEVER CAUSED AND ON ANY THEORY OF LIABILITY,
 * WHETHER IN CONTRACT, STRICT LIABILITY, OR TORT (INCLUDING NEGLIGENCE OR
 * OTHERWISE) ARISING IN ANY WAY OUT OF THE USE OF THIS SOFTWARE,
 * EVEN IF ADVISED OF THE POSSIBILITY OF SUCH DAMAGE.
 */

/*
 *  ============ ti_msp_dl_config.c =============
 *  Configured MSPM0 DriverLib module definitions
 *
 *  DO NOT EDIT - This file is generated for the MSPM0G350X
 *  by the SysConfig tool.
 */

#include "ti_msp_dl_config.h"

DL_TimerG_backupConfig gPWM_ROD_STEPBackup;
DL_TimerG_backupConfig gTIMER_SYSBackup;

/*
 *  ======== SYSCFG_DL_init ========
 *  Perform any initialization needed before using any board APIs
 */
SYSCONFIG_WEAK void SYSCFG_DL_init(void)
{
    SYSCFG_DL_initPower();
    SYSCFG_DL_GPIO_init();
    /* Module-Specific Initializations*/
    SYSCFG_DL_SYSCTL_init();
    SYSCFG_DL_PWM_MOTOR_init();
    SYSCFG_DL_PWM_ROD_STEP_init();
    SYSCFG_DL_TIMER_SYS_init();
    SYSCFG_DL_I2C_SHARED_init();
    SYSCFG_DL_UART_DEBUG_init();
    SYSCFG_DL_UART_K230_init();
    SYSCFG_DL_UART_JY61P_init();
    /* Ensure backup structures have no valid state */
	gPWM_ROD_STEPBackup.backupRdy 	= false;
	gTIMER_SYSBackup.backupRdy 	= false;


}
/*
 * User should take care to save and restore register configuration in application.
 * See Retention Configuration section for more details.
 */
SYSCONFIG_WEAK bool SYSCFG_DL_saveConfiguration(void)
{
    bool retStatus = true;

	retStatus &= DL_TimerG_saveConfiguration(PWM_ROD_STEP_INST, &gPWM_ROD_STEPBackup);
	retStatus &= DL_TimerG_saveConfiguration(TIMER_SYS_INST, &gTIMER_SYSBackup);

    return retStatus;
}


SYSCONFIG_WEAK bool SYSCFG_DL_restoreConfiguration(void)
{
    bool retStatus = true;

	retStatus &= DL_TimerG_restoreConfiguration(PWM_ROD_STEP_INST, &gPWM_ROD_STEPBackup, false);
	retStatus &= DL_TimerG_restoreConfiguration(TIMER_SYS_INST, &gTIMER_SYSBackup, false);

    return retStatus;
}

SYSCONFIG_WEAK void SYSCFG_DL_initPower(void)
{
    DL_GPIO_reset(GPIOA);
    DL_GPIO_reset(GPIOB);
    DL_TimerG_reset(PWM_MOTOR_INST);
    DL_TimerG_reset(PWM_ROD_STEP_INST);
    DL_TimerG_reset(TIMER_SYS_INST);
    DL_I2C_reset(I2C_SHARED_INST);
    DL_UART_Main_reset(UART_DEBUG_INST);
    DL_UART_Main_reset(UART_K230_INST);
    DL_UART_Main_reset(UART_JY61P_INST);

    DL_GPIO_enablePower(GPIOA);
    DL_GPIO_enablePower(GPIOB);
    DL_TimerG_enablePower(PWM_MOTOR_INST);
    DL_TimerG_enablePower(PWM_ROD_STEP_INST);
    DL_TimerG_enablePower(TIMER_SYS_INST);
    DL_I2C_enablePower(I2C_SHARED_INST);
    DL_UART_Main_enablePower(UART_DEBUG_INST);
    DL_UART_Main_enablePower(UART_K230_INST);
    DL_UART_Main_enablePower(UART_JY61P_INST);
    delay_cycles(POWER_STARTUP_DELAY);
}

SYSCONFIG_WEAK void SYSCFG_DL_GPIO_init(void)
{

    DL_GPIO_initPeripheralOutputFunction(GPIO_PWM_MOTOR_C0_IOMUX,GPIO_PWM_MOTOR_C0_IOMUX_FUNC);
    DL_GPIO_enableOutput(GPIO_PWM_MOTOR_C0_PORT, GPIO_PWM_MOTOR_C0_PIN);
    DL_GPIO_initPeripheralOutputFunction(GPIO_PWM_MOTOR_C1_IOMUX,GPIO_PWM_MOTOR_C1_IOMUX_FUNC);
    DL_GPIO_enableOutput(GPIO_PWM_MOTOR_C1_PORT, GPIO_PWM_MOTOR_C1_PIN);
    DL_GPIO_initPeripheralOutputFunction(GPIO_PWM_ROD_STEP_C1_IOMUX,GPIO_PWM_ROD_STEP_C1_IOMUX_FUNC);
    DL_GPIO_enableOutput(GPIO_PWM_ROD_STEP_C1_PORT, GPIO_PWM_ROD_STEP_C1_PIN);

    DL_GPIO_initPeripheralInputFunctionFeatures(GPIO_I2C_SHARED_IOMUX_SDA,
        GPIO_I2C_SHARED_IOMUX_SDA_FUNC, DL_GPIO_INVERSION_DISABLE,
        DL_GPIO_RESISTOR_NONE, DL_GPIO_HYSTERESIS_DISABLE,
        DL_GPIO_WAKEUP_DISABLE);
    DL_GPIO_initPeripheralInputFunctionFeatures(GPIO_I2C_SHARED_IOMUX_SCL,
        GPIO_I2C_SHARED_IOMUX_SCL_FUNC, DL_GPIO_INVERSION_DISABLE,
        DL_GPIO_RESISTOR_NONE, DL_GPIO_HYSTERESIS_DISABLE,
        DL_GPIO_WAKEUP_DISABLE);
    DL_GPIO_enableHiZ(GPIO_I2C_SHARED_IOMUX_SDA);
    DL_GPIO_enableHiZ(GPIO_I2C_SHARED_IOMUX_SCL);

    DL_GPIO_initPeripheralOutputFunction(
        GPIO_UART_DEBUG_IOMUX_TX, GPIO_UART_DEBUG_IOMUX_TX_FUNC);
    DL_GPIO_initPeripheralInputFunction(
        GPIO_UART_DEBUG_IOMUX_RX, GPIO_UART_DEBUG_IOMUX_RX_FUNC);
    DL_GPIO_initPeripheralOutputFunction(
        GPIO_UART_K230_IOMUX_TX, GPIO_UART_K230_IOMUX_TX_FUNC);
    DL_GPIO_initPeripheralInputFunction(
        GPIO_UART_K230_IOMUX_RX, GPIO_UART_K230_IOMUX_RX_FUNC);
    DL_GPIO_initPeripheralOutputFunction(
        GPIO_UART_JY61P_IOMUX_TX, GPIO_UART_JY61P_IOMUX_TX_FUNC);
    DL_GPIO_initPeripheralInputFunction(
        GPIO_UART_JY61P_IOMUX_RX, GPIO_UART_JY61P_IOMUX_RX_FUNC);

    DL_GPIO_initDigitalOutput(GPIO_MOTOR_L_IN1_IOMUX);

    DL_GPIO_initDigitalOutput(GPIO_MOTOR_L_IN2_IOMUX);

    DL_GPIO_initDigitalOutput(GPIO_MOTOR_R_IN1_IOMUX);

    DL_GPIO_initDigitalOutput(GPIO_MOTOR_R_IN2_IOMUX);

    DL_GPIO_initDigitalInputFeatures(GPIO_ENCODER_L_A_IOMUX,
		 DL_GPIO_INVERSION_DISABLE, DL_GPIO_RESISTOR_PULL_UP,
		 DL_GPIO_HYSTERESIS_DISABLE, DL_GPIO_WAKEUP_DISABLE);

    DL_GPIO_initDigitalInputFeatures(GPIO_ENCODER_L_B_IOMUX,
		 DL_GPIO_INVERSION_DISABLE, DL_GPIO_RESISTOR_PULL_UP,
		 DL_GPIO_HYSTERESIS_DISABLE, DL_GPIO_WAKEUP_DISABLE);

    DL_GPIO_initDigitalInputFeatures(GPIO_ENCODER_R_A_IOMUX,
		 DL_GPIO_INVERSION_DISABLE, DL_GPIO_RESISTOR_PULL_UP,
		 DL_GPIO_HYSTERESIS_DISABLE, DL_GPIO_WAKEUP_DISABLE);

    DL_GPIO_initDigitalInputFeatures(GPIO_ENCODER_R_B_IOMUX,
		 DL_GPIO_INVERSION_DISABLE, DL_GPIO_RESISTOR_PULL_UP,
		 DL_GPIO_HYSTERESIS_DISABLE, DL_GPIO_WAKEUP_DISABLE);

    DL_GPIO_initDigitalInputFeatures(GPIO_IR8_X1_IOMUX,
		 DL_GPIO_INVERSION_DISABLE, DL_GPIO_RESISTOR_NONE,
		 DL_GPIO_HYSTERESIS_DISABLE, DL_GPIO_WAKEUP_DISABLE);

    DL_GPIO_initDigitalInputFeatures(GPIO_IR8_X2_IOMUX,
		 DL_GPIO_INVERSION_DISABLE, DL_GPIO_RESISTOR_NONE,
		 DL_GPIO_HYSTERESIS_DISABLE, DL_GPIO_WAKEUP_DISABLE);

    DL_GPIO_initDigitalInputFeatures(GPIO_IR8_X3_IOMUX,
		 DL_GPIO_INVERSION_DISABLE, DL_GPIO_RESISTOR_NONE,
		 DL_GPIO_HYSTERESIS_DISABLE, DL_GPIO_WAKEUP_DISABLE);

    DL_GPIO_initDigitalInputFeatures(GPIO_IR8_X4_IOMUX,
		 DL_GPIO_INVERSION_DISABLE, DL_GPIO_RESISTOR_NONE,
		 DL_GPIO_HYSTERESIS_DISABLE, DL_GPIO_WAKEUP_DISABLE);

    DL_GPIO_initDigitalInputFeatures(GPIO_IR8_X5_IOMUX,
		 DL_GPIO_INVERSION_DISABLE, DL_GPIO_RESISTOR_NONE,
		 DL_GPIO_HYSTERESIS_DISABLE, DL_GPIO_WAKEUP_DISABLE);

    DL_GPIO_initDigitalInputFeatures(GPIO_IR8_X6_IOMUX,
		 DL_GPIO_INVERSION_DISABLE, DL_GPIO_RESISTOR_NONE,
		 DL_GPIO_HYSTERESIS_DISABLE, DL_GPIO_WAKEUP_DISABLE);

    DL_GPIO_initDigitalInputFeatures(GPIO_IR8_X7_IOMUX,
		 DL_GPIO_INVERSION_DISABLE, DL_GPIO_RESISTOR_NONE,
		 DL_GPIO_HYSTERESIS_DISABLE, DL_GPIO_WAKEUP_DISABLE);

    DL_GPIO_initDigitalInputFeatures(GPIO_IR8_X8_IOMUX,
		 DL_GPIO_INVERSION_DISABLE, DL_GPIO_RESISTOR_NONE,
		 DL_GPIO_HYSTERESIS_DISABLE, DL_GPIO_WAKEUP_DISABLE);

    DL_GPIO_initDigitalInputFeatures(GPIO_KEYS_KEY1_IOMUX,
		 DL_GPIO_INVERSION_DISABLE, DL_GPIO_RESISTOR_PULL_UP,
		 DL_GPIO_HYSTERESIS_DISABLE, DL_GPIO_WAKEUP_DISABLE);

    DL_GPIO_initDigitalInputFeatures(GPIO_KEYS_KEY2_IOMUX,
		 DL_GPIO_INVERSION_DISABLE, DL_GPIO_RESISTOR_PULL_UP,
		 DL_GPIO_HYSTERESIS_DISABLE, DL_GPIO_WAKEUP_DISABLE);

    DL_GPIO_initDigitalInputFeatures(GPIO_KEYS_KEY3_IOMUX,
		 DL_GPIO_INVERSION_DISABLE, DL_GPIO_RESISTOR_PULL_UP,
		 DL_GPIO_HYSTERESIS_DISABLE, DL_GPIO_WAKEUP_DISABLE);

    DL_GPIO_initDigitalInputFeatures(GPIO_KEYS_KEY4_IOMUX,
		 DL_GPIO_INVERSION_DISABLE, DL_GPIO_RESISTOR_PULL_UP,
		 DL_GPIO_HYSTERESIS_DISABLE, DL_GPIO_WAKEUP_DISABLE);

    DL_GPIO_initDigitalOutput(GPIO_BOARD_IO_BEEP_IOMUX);

    DL_GPIO_initDigitalOutput(GPIO_NRF_NRF_CE_IOMUX);

    DL_GPIO_initDigitalOutput(GPIO_NRF_NRF_CSN_IOMUX);

    DL_GPIO_initDigitalOutput(GPIO_NRF_NRF_SCK_IOMUX);

    DL_GPIO_initDigitalOutput(GPIO_NRF_NRF_MOSI_IOMUX);

    DL_GPIO_initDigitalInputFeatures(GPIO_NRF_NRF_MISO_IOMUX,
		 DL_GPIO_INVERSION_DISABLE, DL_GPIO_RESISTOR_NONE,
		 DL_GPIO_HYSTERESIS_DISABLE, DL_GPIO_WAKEUP_DISABLE);

    DL_GPIO_initDigitalOutput(GPIO_ROD_STEPPER_ROD_DIR_IOMUX);

    DL_GPIO_initDigitalOutput(GPIO_ROD_STEPPER_ROD_EN_IOMUX);

    DL_GPIO_initDigitalInputFeatures(GPIO_ROD_ENCODER_ROD_ENC_A_IOMUX,
		 DL_GPIO_INVERSION_DISABLE, DL_GPIO_RESISTOR_PULL_UP,
		 DL_GPIO_HYSTERESIS_DISABLE, DL_GPIO_WAKEUP_DISABLE);

    DL_GPIO_initDigitalInputFeatures(GPIO_ROD_ENCODER_ROD_ENC_B_IOMUX,
		 DL_GPIO_INVERSION_DISABLE, DL_GPIO_RESISTOR_PULL_UP,
		 DL_GPIO_HYSTERESIS_DISABLE, DL_GPIO_WAKEUP_DISABLE);

    DL_GPIO_clearPins(GPIOA, GPIO_MOTOR_R_IN1_PIN |
		GPIO_BOARD_IO_BEEP_PIN |
		GPIO_NRF_NRF_SCK_PIN |
		GPIO_NRF_NRF_MOSI_PIN);
    DL_GPIO_setPins(GPIOA, GPIO_NRF_NRF_CSN_PIN);
    DL_GPIO_enableOutput(GPIOA, GPIO_MOTOR_R_IN1_PIN |
		GPIO_BOARD_IO_BEEP_PIN |
		GPIO_NRF_NRF_CSN_PIN |
		GPIO_NRF_NRF_SCK_PIN |
		GPIO_NRF_NRF_MOSI_PIN);
    DL_GPIO_setUpperPinsPolarity(GPIOA, DL_GPIO_PIN_26_EDGE_RISE_FALL |
		DL_GPIO_PIN_25_EDGE_RISE_FALL);
    DL_GPIO_setLowerPinsInputFilter(GPIOA, DL_GPIO_PIN_14_INPUT_FILTER_8_CYCLES |
		DL_GPIO_PIN_15_INPUT_FILTER_8_CYCLES);
    DL_GPIO_setUpperPinsInputFilter(GPIOA, DL_GPIO_PIN_26_INPUT_FILTER_8_CYCLES |
		DL_GPIO_PIN_27_INPUT_FILTER_8_CYCLES |
		DL_GPIO_PIN_25_INPUT_FILTER_8_CYCLES |
		DL_GPIO_PIN_22_INPUT_FILTER_8_CYCLES);
    DL_GPIO_clearInterruptStatus(GPIOA, GPIO_ENCODER_L_A_PIN |
		GPIO_ENCODER_R_A_PIN);
    DL_GPIO_enableInterrupt(GPIOA, GPIO_ENCODER_L_A_PIN |
		GPIO_ENCODER_R_A_PIN);
    DL_GPIO_clearPins(GPIOB, GPIO_MOTOR_L_IN1_PIN |
		GPIO_MOTOR_L_IN2_PIN |
		GPIO_MOTOR_R_IN2_PIN |
		GPIO_NRF_NRF_CE_PIN |
		GPIO_ROD_STEPPER_ROD_DIR_PIN |
		GPIO_ROD_STEPPER_ROD_EN_PIN);
    DL_GPIO_enableOutput(GPIOB, GPIO_MOTOR_L_IN1_PIN |
		GPIO_MOTOR_L_IN2_PIN |
		GPIO_MOTOR_R_IN2_PIN |
		GPIO_NRF_NRF_CE_PIN |
		GPIO_ROD_STEPPER_ROD_DIR_PIN |
		GPIO_ROD_STEPPER_ROD_EN_PIN);
    DL_GPIO_setLowerPinsPolarity(GPIOB, DL_GPIO_PIN_0_EDGE_RISE_FALL);
    DL_GPIO_setUpperPinsPolarity(GPIOB, DL_GPIO_PIN_18_EDGE_RISE_FALL);
    DL_GPIO_setLowerPinsInputFilter(GPIOB, DL_GPIO_PIN_11_INPUT_FILTER_8_CYCLES |
		DL_GPIO_PIN_13_INPUT_FILTER_8_CYCLES |
		DL_GPIO_PIN_1_INPUT_FILTER_8_CYCLES |
		DL_GPIO_PIN_14_INPUT_FILTER_8_CYCLES |
		DL_GPIO_PIN_4_INPUT_FILTER_8_CYCLES);
    DL_GPIO_setUpperPinsInputFilter(GPIOB, DL_GPIO_PIN_23_INPUT_FILTER_8_CYCLES);
    DL_GPIO_clearInterruptStatus(GPIOB, GPIO_ROD_ENCODER_ROD_ENC_A_PIN |
		GPIO_ROD_ENCODER_ROD_ENC_B_PIN);
    DL_GPIO_enableInterrupt(GPIOB, GPIO_ROD_ENCODER_ROD_ENC_A_PIN |
		GPIO_ROD_ENCODER_ROD_ENC_B_PIN);

}



SYSCONFIG_WEAK void SYSCFG_DL_SYSCTL_init(void)
{

	//Low Power Mode is configured to be SLEEP0
    DL_SYSCTL_setBORThreshold(DL_SYSCTL_BOR_THRESHOLD_LEVEL_0);

    
	DL_SYSCTL_setSYSOSCFreq(DL_SYSCTL_SYSOSC_FREQ_BASE);
	/* Set default configuration */
	DL_SYSCTL_disableHFXT();
	DL_SYSCTL_disableSYSPLL();

}


/*
 * Timer clock configuration to be sourced by  / 1 (32000000 Hz)
 * timerClkFreq = (timerClkSrc / (timerClkDivRatio * (timerClkPrescale + 1)))
 *   32000000 Hz = 32000000 Hz / (1 * (0 + 1))
 */
static const DL_TimerG_ClockConfig gPWM_MOTORClockConfig = {
    .clockSel = DL_TIMER_CLOCK_BUSCLK,
    .divideRatio = DL_TIMER_CLOCK_DIVIDE_1,
    .prescale = 0U
};

static const DL_TimerG_PWMConfig gPWM_MOTORConfig = {
    .pwmMode = DL_TIMER_PWM_MODE_EDGE_ALIGN,
    .period = 1600,
    .isTimerWithFourCC = false,
    .startTimer = DL_TIMER_STOP,
};

SYSCONFIG_WEAK void SYSCFG_DL_PWM_MOTOR_init(void) {

    DL_TimerG_setClockConfig(
        PWM_MOTOR_INST, (DL_TimerG_ClockConfig *) &gPWM_MOTORClockConfig);

    DL_TimerG_initPWMMode(
        PWM_MOTOR_INST, (DL_TimerG_PWMConfig *) &gPWM_MOTORConfig);

    DL_TimerG_setCaptureCompareOutCtl(PWM_MOTOR_INST, DL_TIMER_CC_OCTL_INIT_VAL_LOW,
		DL_TIMER_CC_OCTL_INV_OUT_DISABLED, DL_TIMER_CC_OCTL_SRC_FUNCVAL,
		DL_TIMERG_CAPTURE_COMPARE_0_INDEX);

    DL_TimerG_setCaptCompUpdateMethod(PWM_MOTOR_INST, DL_TIMER_CC_UPDATE_METHOD_IMMEDIATE, DL_TIMERG_CAPTURE_COMPARE_0_INDEX);
    DL_TimerG_setCaptureCompareValue(PWM_MOTOR_INST, 1600, DL_TIMER_CC_0_INDEX);

    DL_TimerG_setCaptureCompareOutCtl(PWM_MOTOR_INST, DL_TIMER_CC_OCTL_INIT_VAL_LOW,
		DL_TIMER_CC_OCTL_INV_OUT_DISABLED, DL_TIMER_CC_OCTL_SRC_FUNCVAL,
		DL_TIMERG_CAPTURE_COMPARE_1_INDEX);

    DL_TimerG_setCaptCompUpdateMethod(PWM_MOTOR_INST, DL_TIMER_CC_UPDATE_METHOD_IMMEDIATE, DL_TIMERG_CAPTURE_COMPARE_1_INDEX);
    DL_TimerG_setCaptureCompareValue(PWM_MOTOR_INST, 1600, DL_TIMER_CC_1_INDEX);

    DL_TimerG_enableClock(PWM_MOTOR_INST);


    
    DL_TimerG_setCCPDirection(PWM_MOTOR_INST , DL_TIMER_CC0_OUTPUT | DL_TIMER_CC1_OUTPUT );


}
/*
 * Timer clock configuration to be sourced by  / 1 (32000000 Hz)
 * timerClkFreq = (timerClkSrc / (timerClkDivRatio * (timerClkPrescale + 1)))
 *   1000000 Hz = 32000000 Hz / (1 * (31 + 1))
 */
static const DL_TimerG_ClockConfig gPWM_ROD_STEPClockConfig = {
    .clockSel = DL_TIMER_CLOCK_BUSCLK,
    .divideRatio = DL_TIMER_CLOCK_DIVIDE_1,
    .prescale = 31U
};

static const DL_TimerG_PWMConfig gPWM_ROD_STEPConfig = {
    .pwmMode = DL_TIMER_PWM_MODE_EDGE_ALIGN,
    .period = 2500,
    .isTimerWithFourCC = false,
    .startTimer = DL_TIMER_STOP,
};

SYSCONFIG_WEAK void SYSCFG_DL_PWM_ROD_STEP_init(void) {

    DL_TimerG_setClockConfig(
        PWM_ROD_STEP_INST, (DL_TimerG_ClockConfig *) &gPWM_ROD_STEPClockConfig);

    DL_TimerG_initPWMMode(
        PWM_ROD_STEP_INST, (DL_TimerG_PWMConfig *) &gPWM_ROD_STEPConfig);

    DL_TimerG_setCaptureCompareOutCtl(PWM_ROD_STEP_INST, DL_TIMER_CC_OCTL_INIT_VAL_LOW,
		DL_TIMER_CC_OCTL_INV_OUT_DISABLED, DL_TIMER_CC_OCTL_SRC_FUNCVAL,
		DL_TIMERG_CAPTURE_COMPARE_1_INDEX);

    DL_TimerG_setCaptCompUpdateMethod(PWM_ROD_STEP_INST, DL_TIMER_CC_UPDATE_METHOD_IMMEDIATE, DL_TIMERG_CAPTURE_COMPARE_1_INDEX);
    DL_TimerG_setCaptureCompareValue(PWM_ROD_STEP_INST, 1250, DL_TIMER_CC_1_INDEX);

    DL_TimerG_enableClock(PWM_ROD_STEP_INST);


    DL_TimerG_enableInterrupt(PWM_ROD_STEP_INST , DL_TIMER_INTERRUPT_ZERO_EVENT);

    DL_TimerG_setCCPDirection(PWM_ROD_STEP_INST , DL_TIMER_CC1_OUTPUT );


}



/*
 * Timer clock configuration to be sourced by BUSCLK /  (32000000 Hz)
 * timerClkFreq = (timerClkSrc / (timerClkDivRatio * (timerClkPrescale + 1)))
 *   125000 Hz = 32000000 Hz / (1 * (255 + 1))
 */
static const DL_TimerG_ClockConfig gTIMER_SYSClockConfig = {
    .clockSel    = DL_TIMER_CLOCK_BUSCLK,
    .divideRatio = DL_TIMER_CLOCK_DIVIDE_1,
    .prescale    = 255U,
};

/*
 * Timer load value (where the counter starts from) is calculated as (timerPeriod * timerClockFreq) - 1
 * TIMER_SYS_INST_LOAD_VALUE = (1 ms * 125000 Hz) - 1
 */
static const DL_TimerG_TimerConfig gTIMER_SYSTimerConfig = {
    .period     = TIMER_SYS_INST_LOAD_VALUE,
    .timerMode  = DL_TIMER_TIMER_MODE_PERIODIC,
    .startTimer = DL_TIMER_STOP,
};

SYSCONFIG_WEAK void SYSCFG_DL_TIMER_SYS_init(void) {

    DL_TimerG_setClockConfig(TIMER_SYS_INST,
        (DL_TimerG_ClockConfig *) &gTIMER_SYSClockConfig);

    DL_TimerG_initTimerMode(TIMER_SYS_INST,
        (DL_TimerG_TimerConfig *) &gTIMER_SYSTimerConfig);
    DL_TimerG_enableInterrupt(TIMER_SYS_INST , DL_TIMERG_INTERRUPT_ZERO_EVENT);
    DL_TimerG_enableClock(TIMER_SYS_INST);





}


static const DL_I2C_ClockConfig gI2C_SHAREDClockConfig = {
    .clockSel = DL_I2C_CLOCK_BUSCLK,
    .divideRatio = DL_I2C_CLOCK_DIVIDE_1,
};

SYSCONFIG_WEAK void SYSCFG_DL_I2C_SHARED_init(void) {

    DL_I2C_setClockConfig(I2C_SHARED_INST,
        (DL_I2C_ClockConfig *) &gI2C_SHAREDClockConfig);
    DL_I2C_disableAnalogGlitchFilter(I2C_SHARED_INST);

    /* Configure Controller Mode */
    DL_I2C_resetControllerTransfer(I2C_SHARED_INST);
    /* Set frequency to 100000 Hz*/
    DL_I2C_setTimerPeriod(I2C_SHARED_INST, 31);
    DL_I2C_setControllerTXFIFOThreshold(I2C_SHARED_INST, DL_I2C_TX_FIFO_LEVEL_EMPTY);
    DL_I2C_setControllerRXFIFOThreshold(I2C_SHARED_INST, DL_I2C_RX_FIFO_LEVEL_BYTES_1);
    DL_I2C_enableControllerClockStretching(I2C_SHARED_INST);


    /* Enable module */
    DL_I2C_enableController(I2C_SHARED_INST);


}


static const DL_UART_Main_ClockConfig gUART_DEBUGClockConfig = {
    .clockSel    = DL_UART_MAIN_CLOCK_BUSCLK,
    .divideRatio = DL_UART_MAIN_CLOCK_DIVIDE_RATIO_1
};

static const DL_UART_Main_Config gUART_DEBUGConfig = {
    .mode        = DL_UART_MAIN_MODE_NORMAL,
    .direction   = DL_UART_MAIN_DIRECTION_TX_RX,
    .flowControl = DL_UART_MAIN_FLOW_CONTROL_NONE,
    .parity      = DL_UART_MAIN_PARITY_NONE,
    .wordLength  = DL_UART_MAIN_WORD_LENGTH_8_BITS,
    .stopBits    = DL_UART_MAIN_STOP_BITS_ONE
};

SYSCONFIG_WEAK void SYSCFG_DL_UART_DEBUG_init(void)
{
    DL_UART_Main_setClockConfig(UART_DEBUG_INST, (DL_UART_Main_ClockConfig *) &gUART_DEBUGClockConfig);

    DL_UART_Main_init(UART_DEBUG_INST, (DL_UART_Main_Config *) &gUART_DEBUGConfig);
    /*
     * Configure baud rate by setting oversampling and baud rate divisors.
     *  Target baud rate: 9600
     *  Actual baud rate: 9600.24
     */
    DL_UART_Main_setOversampling(UART_DEBUG_INST, DL_UART_OVERSAMPLING_RATE_16X);
    DL_UART_Main_setBaudRateDivisor(UART_DEBUG_INST, UART_DEBUG_IBRD_32_MHZ_9600_BAUD, UART_DEBUG_FBRD_32_MHZ_9600_BAUD);


    /* Configure Interrupts */
    DL_UART_Main_enableInterrupt(UART_DEBUG_INST,
                                 DL_UART_MAIN_INTERRUPT_RX);


    DL_UART_Main_enable(UART_DEBUG_INST);
}

static const DL_UART_Main_ClockConfig gUART_K230ClockConfig = {
    .clockSel    = DL_UART_MAIN_CLOCK_BUSCLK,
    .divideRatio = DL_UART_MAIN_CLOCK_DIVIDE_RATIO_1
};

static const DL_UART_Main_Config gUART_K230Config = {
    .mode        = DL_UART_MAIN_MODE_NORMAL,
    .direction   = DL_UART_MAIN_DIRECTION_TX_RX,
    .flowControl = DL_UART_MAIN_FLOW_CONTROL_NONE,
    .parity      = DL_UART_MAIN_PARITY_NONE,
    .wordLength  = DL_UART_MAIN_WORD_LENGTH_8_BITS,
    .stopBits    = DL_UART_MAIN_STOP_BITS_ONE
};

SYSCONFIG_WEAK void SYSCFG_DL_UART_K230_init(void)
{
    DL_UART_Main_setClockConfig(UART_K230_INST, (DL_UART_Main_ClockConfig *) &gUART_K230ClockConfig);

    DL_UART_Main_init(UART_K230_INST, (DL_UART_Main_Config *) &gUART_K230Config);
    /*
     * Configure baud rate by setting oversampling and baud rate divisors.
     *  Target baud rate: 460800
     *  Actual baud rate: 460431.65
     */
    DL_UART_Main_setOversampling(UART_K230_INST, DL_UART_OVERSAMPLING_RATE_16X);
    DL_UART_Main_setBaudRateDivisor(UART_K230_INST, UART_K230_IBRD_32_MHZ_460800_BAUD, UART_K230_FBRD_32_MHZ_460800_BAUD);


    /* Configure Interrupts */
    DL_UART_Main_enableInterrupt(UART_K230_INST,
                                 DL_UART_MAIN_INTERRUPT_RX);


    DL_UART_Main_enable(UART_K230_INST);
}

static const DL_UART_Main_ClockConfig gUART_JY61PClockConfig = {
    .clockSel    = DL_UART_MAIN_CLOCK_BUSCLK,
    .divideRatio = DL_UART_MAIN_CLOCK_DIVIDE_RATIO_1
};

static const DL_UART_Main_Config gUART_JY61PConfig = {
    .mode        = DL_UART_MAIN_MODE_NORMAL,
    .direction   = DL_UART_MAIN_DIRECTION_TX_RX,
    .flowControl = DL_UART_MAIN_FLOW_CONTROL_NONE,
    .parity      = DL_UART_MAIN_PARITY_NONE,
    .wordLength  = DL_UART_MAIN_WORD_LENGTH_8_BITS,
    .stopBits    = DL_UART_MAIN_STOP_BITS_ONE
};

SYSCONFIG_WEAK void SYSCFG_DL_UART_JY61P_init(void)
{
    DL_UART_Main_setClockConfig(UART_JY61P_INST, (DL_UART_Main_ClockConfig *) &gUART_JY61PClockConfig);

    DL_UART_Main_init(UART_JY61P_INST, (DL_UART_Main_Config *) &gUART_JY61PConfig);
    /*
     * Configure baud rate by setting oversampling and baud rate divisors.
     *  Target baud rate: 9600
     *  Actual baud rate: 9600.24
     */
    DL_UART_Main_setOversampling(UART_JY61P_INST, DL_UART_OVERSAMPLING_RATE_16X);
    DL_UART_Main_setBaudRateDivisor(UART_JY61P_INST, UART_JY61P_IBRD_32_MHZ_9600_BAUD, UART_JY61P_FBRD_32_MHZ_9600_BAUD);


    /* Configure Interrupts */
    DL_UART_Main_enableInterrupt(UART_JY61P_INST,
                                 DL_UART_MAIN_INTERRUPT_RX);


    DL_UART_Main_enable(UART_JY61P_INST);
}
