Greyd0ve/nuedc_21f_car_mspm0/(commit log)

2026-07-06 优化代码逻辑
2026-07-09 修改编码器IO口映射
2026-07-12 修改OLED的IO口映射
2026-07-13 优化测试代码
2026-07-13 测试串口功能代码
2026-07-13 测试串口功能代码v2
2026-07-13 恢复板级测试
2026-07-14 速度PID闭环调试V5
2026-07-14 速度PID闭环调试V6
2026-07-14 速度PID闭环调试V7
2026-07-14 速度PID闭环调试V12
2026-07-15 优化角点中心线提前退出逻辑
2026-07-15 优化循迹逻辑v6
2026-07-15 修改MPU循迹的驱动代码v7
2026-07-15 优化MPU软件读取IIC
2026-07-16 修正后置模式电机方向并清理重复宏定义
    后置LEFT_MOTOR_DIR (+1), RIGHT_MOTOR_DIR (-1)：实测正向PWM=后转
    PWM别名/编码器别名移出#if统一定义，消除重复
    README补充实测结果说明
    [Board_Config.h]
2026-07-16 修正后置模式角点左转方向
    ECAR_TURN_SIGN: -1.0f->1.0f, 实测原值右转, 取反后左转90度
2026-07-16 提至55cm/s并取消55%软件PWM限幅
    base: 40->55cm/s, g_pwmLimit: 0.55*MAX->MAX, wheel_target_limit: 40->80cm/s
    Motor.c ±PWM_MAX_DUTY硬件保护保留,TUNE_PWM_SLEW_STEP保留
2026-07-16 init 2021 F drug car framework from E car base
2026-07-16 strip contest logic keep portable car base drivers
2026-07-16 clean portable car base reset and monitor behavior
    [app_car_base.c, app_config.h, app_line.c]
2026-07-16 add 2021 f basic outbound line following framework
2026-07-16 tune 21f turn parameters and reset encoder totals
    [app_21f_car.c, app_21f_car.h]
2026-07-16 update 21f cross detection and room led prompt
2026-07-16 set rooms 3 4 detect distance to 120cm
2026-07-16 set room entry distance to 35cm
2026-07-16 add k230 vision uart2 communication
2026-07-16 fix k230 uart2 pending state protection and shared start
    [app_21f_car.c]
2026-07-16 fix missing F21Car_KeyProcess declaration
    [app_21f_car.c]
2026-07-16 remove const qualifier on uart2 config structs
2026-07-16 move k230 vision from uart2 to serial uart1
2026-07-16 change uart debug baudrate from 9600 to 115200
2026-07-16 set uart1 baudrate to 115200 in syscfg
2026-07-17 set line speed to fixed values 15 20 25
    [app_21f_car.h, ti_msp_dl_config.c, ti_msp_dl_config.h]
2026-07-17 fix finish state priority over vision parse
    [app_21f_car.c]
2026-07-17 add unlock quiet window to prevent stale num retrigger
    [app_21f_car.c]
2026-07-17 shorten return final straight by 15cm
    [app_21f_car.c]
2026-07-17 blink led twice when sending unlock
2026-07-17 change rooms 1 2 detect distance to 15cm
2026-07-17 change far first detect to 180cm
2026-07-17 remove all debug serial logs from uart1
2026-07-17 swap room 5678 routes: 5-7 6-8
    [app_21f_car.c]
2026-07-17 重构项目文件树
2026-07-17 重构项目文件树v2
2026-07-18 add nrf24l01 software spi driver to both cars
2026-07-18 fix nrf24l01 gpio check roles radio integration
    [NRF24L01.c, app_21f_car.c, app_21f_car.h, app_config.h, app_radio.c, app_radio.h, main.c]
2026-07-18 fix nrf gpio using iomux sysconfig generate proper macros
    [NRF24L01.c, NRF24L01.h, app_radio.c, ti_msp_dl_config.c, ti_msp_dl_config.h]
2026-07-18 add uart2 for debug separate from k230 uart1
2026-07-18 fix uart split add ping task and target guard
    [DebugSerial.c, DebugSerial.h, app_21f_car.c, main.c]
2026-07-18 Fix cooperative radio retry flow
    [app_coop.c, app_coop.h, app_radio.c, app_radio.h]
2026-07-18 fix master car flash2 ulink driver forcing ul2cm3
2026-07-18 update sysconfig generated files after gpio fix
    [ti_msp_dl_config.c, ti_msp_dl_config.h]
2026-07-18 swap uart assignments: uart1 debug uart0 k230
    [Board_Config.h, DebugSerial.c, ti_msp_dl_config.c, ti_msp_dl_config.h]
2026-07-19 fix uart isr duplicate: serial uses k230 handler
    [Serial.c, ti_msp_dl_config.h]
2026-07-19 add led blink hint for coop target select
2026-07-19 enable board test mode for motor and gray
2026-07-19 fix slave car gray black level to 0.0
    [app_car_state.c]
2026-07-19 enable imu only board test mode
2026-07-19 fix imu gpio release and bus read calibrate logic
    [app_board_test.c]
2026-07-19 revert to motor board test mode
    [app_board_test.c, app_config.h]
2026-07-20 restore imu board test mode
2026-07-20 fix imu burst read residual yaw fault management
    [app_board_test.c]
2026-07-21 add nrf24l01 radio board test mode
2026-07-21 remove all mpu6050 imu driver and test code
2026-07-22 disable board test enable task mode switching
2026-07-22 change coop return detect to 10cm
2026-07-22 change coop room run to 30cm
2026-07-22 flip slave car black level to 1.0
    [app_car_state.c]
2026-07-22 revert slave black level to old module
    [app_car_state.c]
2026-07-22 enable slave gray motor board test mode
2026-07-22 add stepper encoder test with quadrature decoding
2026-07-22 fix stepper encoder gpio edge polarity and snapshot api
    [Encoder.c, StepperEncoder.c, StepperEncoder.h, app_board_test.c, app_config.h]
2026-07-22 fix stepper encoder sysconfig macros signed window k4
    [StepperEncoder.c, app_board_test.c, app_config.h, ti_msp_dl_config.h]
2026-07-22 enable master stepper encoder board test
2026-07-22 恢复正常任务模式，调整循迹/协同参数
    - app_config.h: 关闭板测模式(ECAR_BOARD_TEST_MODE=0)，修复宏定义顺序，CPR改为4096，添加DRIVER_PULSE_PER_REV=3200
    - main.c: 添加正常任务启动确认日志
    - app_21f_car.h: F21_CROSS_ADVANCE_CM 4->6cm，F21_LINE_BASE_SPEED_CMPS 18->20cm/s
    - app_coop.c: F21_COOP_ROOM_RUN_CM 30->35cm
    [app_21f_car.h, app_config.h, app_coop.c, main.c]
2026-07-23 新增K230视觉循迹第一阶段(直线跟踪)
    - App/app_vision_link: K230 [trk1,...]帧解析模块
    - App/app_vision_track: 状态机(IDLE/ACQUIRE/RUN/LOST/STOP)+视觉横向航向控制
    - app_config.h: 新增F21_VISION_TRACK_TEST_MODE=1
    - main.c: 视觉测试模式分支,跳过灰度/NRF/双车协同
    - 控制参数: 10cm/s基础速度, K_Y=0.004, K_A=0.02, 置信度>=70
    - 0 Error, 0 Warning, AXF/HEX已生成
    [app_config.h, app_vision_link.c, app_vision_link.h, app_vision_track.c, app_vision_track.h, main.c]
2026-07-23 修复K230视觉循迹第一阶段: 方括号解析、dEy、真实1ms、UART溢出、超时等
    - 方括号方案A: [和]存入缓冲区后完整传给ParseFields
    - ParseInt32严格校验: 空字段/负号无数字/溢出均返回非法
    - 微分项修复: 先计算dEy再更新s_lastEy
    - 重复seq不刷新receiveTimeMs, 增加duplicateFrameCount
    - Timer_GetMillis()替代s_systemTimeMs+=10虚假累加
    - App_VisionTrack_Task100ms改为空函数, 关闭周期Debug日志
    - UART溢出通过Serial_GetRxOverflowCount()真实检测, 溢出即停车
    - Reset清除s_rxIdx/s_inFrame半帧状态
    - [ready,...]帧单独识别不产生parseError
    - 移除VISION_TRACK_TIMEOUT_MS, 仅保留FRESH_LIMIT_MS=150
    - A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
    [Timer.c, app_vision_link.c, app_vision_link.h, app_vision_track.c, app_vision_track.h]
2026-07-23 修复超长帧安全处理和Reset清理UART旧字节
    - ]收到时若缓冲区已满, 提前丢弃不调用解析, 避免使用未正确结束的残留缓冲区
    - App_VisionLink_Reset()增加有限循环(最大128字节)清除Serial缓冲区旧数据, 防止旧半帧拼接
    [app_vision_link.c]
2026-07-23 迁移至K230 24字节二进制道路数据协议
    - 波特率115200→460800, SysConfig重新生成
    - 二进制收帧状态机: WAIT_AA→WAIT_55→COLLECT, 支持噪声同步/AA AA 55/逐帧解析
    - CRC16-CCITT-FALSE (0x1021, 初值0xFFFF), 测试向量0xF9D2已验证
    - VisionTrackFrame_t新增transportValid/visionValid双有效标志
    - visionValid=0的CRC正确帧立即导致LOST停车
    - eyControl=lateralErrorDeciMm(0.1mm), eaControl=headingErrorCentiDeg/10(0.01→0.1deg)
    - 移除旧ASCII flags/confidence硬阈值, 有效性仅由K230 visionValid决定
    - SendTrackMode/SendIdleMode置空(反向控制协议未定义)
    - 统计: crcErrorCount/headerSyncLossCount/versionErrorCount/messageTypeEr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
2026-07-23 feat(slave_car): migrate from DC+TB6612 to stepper+D36A dual-channel driver
    - Add StepperMotor.c/h with TIMG7/TIMG8 hardware STEP generation
    - Implement non-blocking accel/decel ramp (1ms tick in ISR)
    - Upgrade Encoder.c to 4x quadrature (A+B phase, both edges)
    - Add 7-level stepper board test mode (K1-K4, 2240-16000Hz)
    - Repurpose freed TB6612 pins for DIR_L/R(PB17/PB19) EN_L/R(PA16/PB24)
    - STEP_L=PA3(TIMG7_CCP0), STEP_R=PA5(TIMG8_CCP0) - independent timers
    - Config: 3200 step/rev, 4096 enc/rev, 600RPM full speed
    - Maintain backward compat with #if ECAR_MOTOR_TYPE_STEPPER
2026-07-23 fix(slave_car): remap stepper/encoder IO to PB00-PB25, remove EN GPIO
    - STEP_L: PA3→PB15 (TIMG7 CC0), STEP_R: PA5→PB16 (TIMG8 CC1)
    - DIR_L: PB17→PB18, DIR_R: PB19→PB25
    - EN_L/EN_R: removed GPIO (D36A hardware always enabled)
    - ENC_L_A: PA26→PB05, ENC_L_B: PA27→PB12
    - ENC_R_A: PA25→PB08, ENC_R_B: PA14→PB00
    - All encoder pins on GPIOB, shared GPIOB_INT_IRQn
    - 4x quadrature with 16-entry lookup table + illegal jump counter
    - Step counter with phase accumulator for accurate encoder error
    - Board test: 500ms period, direction sign correction, encoder total diff
    - OLED PB08 conflict resolved: BOARD_OLED_USE_H8_I2C=0, ECAR_OLED_ENABLE=0
    - Updated .syscfg + ti_msp_dl_config.c/h for n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
    [Board_Config.h, Encoder.c, Encoder.h, StepperMotor.c, StepperMotor.h, app_board_test.c, app_config.h, main.c]
2026-07-23 fix(slave_car): no-EN mode, safe STEP init, signed step count, direction state machine
    - ECAR_BOARD_TEST_MODE default 0→1, ECAR_TEST_RADIO_ENABLE stays 0
    - No-EN mode: s_leftEnabled/rightEnabled init to 1, enable check guarded by #if
    - Safe init: GPIO output low → timer config → peripheral function (never output glitch)
    - Signed step counter (int32_t) accumulates every 1ms regardless of freq change
    - Direction state machine: ramp to zero → stop STEP → switch DIR → wait 1 tick → accelerate
    - RampOne prevents crossing zero when target and current have opposite signs
    - EmergencyStop locks (s_emergencyStop stays set until ClearEmergencyStop)
    - StepperMotor_ClearStepCount added, cal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
    [StepperMotor.c, StepperMotor.h, app_board_test.c, app_config.h, ti_msp_dl_config.c, ti_msp_dl_config.h]
2026-07-23 fix(slave_car): set forward DIR on init, add startup hold, clear state on stop
    - Init sets DIR_L=HIGH, DIR_R=LOW based on direction sign macros
    - s_startupHold delays first STEP by 1ms for DIR settling
    - StopLeft/Right/All now clear pendingTarget and dirState
    [StepperMotor.c]
2026-07-23 fix(slave_car): add missing Board_Config.h include, fix volatile qualifier warnings
    - app_control.c: add #include Board_Config.h for LEFT/RIGHT_STEPPER_DIR_SIGN
    - StepperMotor.c: StepChannel cur/pendingTarget/dirState params changed to volatile*
    [StepperMotor.c, app_control.c]
2026-07-23 VISION_TRACK_TURN_SIGN -1.0→1.0，uvprojx添加J-Link/SWD TargetDriverDllRegistry
2026-07-23 修复单帧无效导致断续停车: 新增无效帧确认计数
    - 区分通信正常(transportOk)和视觉有效(visionValid)
    - UART溢出/帧超150ms: 立即LOST
    - 单帧visionValid=0: 降速5cm/s直行, 不清零控制历史
    - 连续3帧visionValid=0: 进入LOST
    - 1~2帧临时无效后恢复: s_invalidFrameCount自动清零, 恢复正常控制
    - Init/进入RUN/进入LOST/K2/K3/K4时清零s_invalidFrameCount
    [app_vision_track.c, app_vision_track.h]
2026-07-23 fix(slave_car): correct direction signs based on real hardware test
    - LEFT_STEPPER_DIR_SIGN: +1 -> -1 (DIR_L=LOW=forward for right motor)
    - RIGHT_STEPPER_DIR_SIGN stays -1 (DIR_R=LOW=forward for left motor)
    - D36A channels cross-wired: ST1->right motor, ST2->left motor
    [Board_Config.h]
2026-07-23 fix(slave_car): swap K1/K2 channel mapping to match cross-wired D36A
    - K1 (right physical motor): use LEFT software channel (STEP_L)
    - K2 (left physical motor): use RIGHT software channel (STEP_R)
    - K4 speed-change dispatch also swapped to match
    [app_board_test.c]
2026-07-24 修改步进电机左右轮定义
2026-07-24 fix(slave_car): enable DIR GPIO output, add start-from-stop DIR setup, correct direction signs
    - Root cause: DL_GPIO_enableOutput was missing for DIR_L/DIR_R pins
    - StepChannel now sets DIR + 1ms hold when starting from cur=0
    - LEFT_STEPPER_DIR_SIGN=+1 (PB18 HIGH=right motor forward)
    - RIGHT_STEPPER_DIR_SIGN=-1 (PB25 LOW=left motor forward)
    - Added direction sign and K1/K2 pin-level debug output to banner
    [Board_Config.h, StepperMotor.c, app_board_test.c]
2026-07-24 feat(slave_car): fix stepper channel mapping for basic task, update mechanical params
    - Cross-map logical L/R wheels to hardware STEP_L/STEP_R channels
    - STEP_L(PB15)->physical RIGHT motor, STEP_R(PB16)->physical LEFT motor
    - Add chassis params: track=15.9cm, sensor offset=17.7cm
    - Turn theory: 90deg=2505 enc, 180deg=5010 enc
    - Cross advance: 17.7cm + trim margin
    - ECAR_BOARD_TEST_MODE: 1->0 (switch to basic task mode)
    - Keil build: 0 Error(s), 0 Warning(s)
    [app_21f_car.h, app_config.h, app_control.c]
2026-07-24 docs: add stepper and DC motor mechanical parameters to README
    - Add stepper (D36A) mechanical params: 3200 step/rev, 4096 enc/rev, 600RPM
    - Add DC motor (TB6612) mechanical params: 367 pulses/rev (1x counting)
    - Add common chassis: wheel=6.5cm, track=15.9cm, sensor offset=17.7cm
    - Add turn theory: 90deg=2505 enc, 180deg=5010 enc (stepper)
    - Add stepper IO map (PB15/PB16/PB18/PB25) and encoder (PB05/PB12/PB08/PB00)
    - Document cross-wired D36A channel mapping
2026-07-24 feat(withoutK230): add JY61P IMU driver and board test mode
    - New Hardware/JY61P.c/h: WIT 11-byte frame state machine parser
    - Decodes 0x52 (gyro) and 0x53 (angle) frames
    - Online/offline detection (500ms timeout)
    - Software yaw zeroing, statistics, checksum validation
    - Reuses Serial.c UART0 RX ring buffer (no duplicate ISR)
    - Change UART_K230 SysConfig baud from 115200 to 9600 for JY61P
    - Add ECAR_TEST_JY61P_ENABLE macro with mutual exclusion
    - Add JY61P board test in app_board_test.c:
    - K1=yaw_zero, K2=print_pause, K3=page, K4=clear_stats
    - Angle/diagnostic serial output, optional OLED display
    - Add JY61P.c to Keil Hardware group
    - Verified: default (0E0W), JY61P test (0E0W),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
2026-07-24 fix(withoutK230): repair JY61P board test
    [JY61P.c, JY61P.h, app_board_test.c]
2026-07-24 fix(slave_car): adapt basic task state machine for stepper drive
    [StepperMotor.c, app_21f_car.c, app_21f_car.h, app_car_state.c]
2026-07-24 config: enable JY61P board test mode for testing
2026-07-24 fix(withoutK230): stabilize JY61P board test
    [DebugSerial.c, DebugSerial.h, JY61P.c, JY61P.h, Serial.c, Serial.h, Timer.c]
2026-07-25 fix(slave_car): correct encoder edge configuration and diagnostics
    [DebugSerial.c, DebugSerial.h, Encoder.c, Encoder.h, app_21f_car.c, app_board_test.c, app_config.h]
2026-07-25 fix(slave_car): reliably start debug UART TX
    [DebugSerial.c]
2026-07-25 fix(slave_car): correct right encoder direction
    [Board_Config.h]
2026-07-25 优化视觉循迹的功能
2026-07-25 修复视觉协议状态位定义与K230一致，实现模式发送，增加置信度保护
    - 状态位修正: LEFT_VALID 0x02→0x04, RIGHT_VALID 0x04→0x08, DEGRADED 0x08→0x02
    新增 LEFT_BRANCH(0x10)/RIGHT_BRANCH(0x20)/INTERSECTION(0x40)
    - SendTrackMode/SendIdleMode 实现: 通过K230串口发送[mode,track]/[mode,idle]
    - IsVisionValid 增加 confidence >= VISION_TRACK_MIN_CONFIDENCE(30) 保护
    - 调试日志增加 statusFlags/leftBoundaryValid/rightBoundaryValid 字段
    - flags=0x0D正常双边界帧不再被误判为degraded
    [app_vision_link.c, app_vision_link.h, app_vision_track.c, app_vision_track.h]
2026-07-25 fix(slave_car): calibrate turn thresholds and cross advance distances
    - F21_TURN_90_PULSE: 2010 -> 2405
    - F21_TURN_180_PULSE: 4910 -> 4920
    - F21_CROSS_ADVANCE_BASE_CM: 6.0 -> 17.7 (sensor-to-axle distance)
    - F21_FAR_CROSS_ADVANCE_BASE_CM: 3.0 -> 15.5
    [app_21f_car.h]
2026-07-25 重构为独立纯视觉循迹模式ECAR_VISION_TRACK_MODE
    - F21_VISION_TRACK_TEST_MODE→ECAR_VISION_TRACK_MODE, 增加顶层模式互斥检查
    - main.c: 视觉模式独立最高层分支, 最小初始化(无灰度/NRF/舵机/OLED/F题)
    - app_vision_track: 精简为2状态(STOPPED/RUNNING), 删除ACQUIRE/LOST/IDLE/STOP
    - 控制: 横向P控制(KY=0.008), KA/KD默认0, ey→mm缩放, 左右严格对称
    - 移除综合severity/多级速度平滑/视觉层二次加减速/复杂恢复
    - K2启动→发送[mode,track]→RUNNING, K3停车→强制清零+[mode,idle]→STOPPED
    - visionValid=0/frame超时/mode非TRACK→立即ForcePWMZero不盲走
    - 新增K230模式常量(IDLE/TRACK/TURNING/REACQUIRE/F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
2026-07-25 前进速度6→10cm/s, 转向限幅5→8cm/s
2026-07-25 修正横向误差单位换算，增益提升到实际可用范围
    - 删除VISION_TRACK_KY/KY_SCALE/KA/KD模糊宏
    - 新增VISION_TRACK_ERROR_DECI_MM_TO_MM=0.1(0.1mm→mm)
    - 新增VISION_TRACK_KY_CMPS_PER_MM=0.04(1mm误差→0.04cm/s差速)
    - CalcSteer精简为纯横向P控制: rawSteer=KY*dMM*0.1
    - 验证: +600dMM→+2.4cm/s, -600dMM→-2.4cm/s, 严格对称
    - TURN_SIGN=-1.0f: 转换为MSPM0坐标(路在右→右转)
    - 前进6cm/s, degraded 4.5cm/s, 转向限幅5cm/s
    - K2/K3去除重复的ResetPID/Init调用(ForcePWMZero已处理)
    - e=0时steer=0, 无死区补偿
    [app_vision_track.c, app_vision_track.h]
2026-07-25 UART1调试串口9600→115200, 新增非阻塞视觉诊断日志
    - empty.syscfg: UART_DEBUG波特率9600→115200, SysConfig重新生成
    - DebugSerial: 新增TrySendBuffer/GetTxFreeBytes/GetTxDropCount, TX中断环形缓冲区
    - app_vision_track: 每100ms输出VDBG诊断CSV(26字段), 包含状态/误差/目标/实际/PWM/CRC
    - GetInvalidReason位掩码: NO_TRANSPORT/VISION/MODE/STALE/STOPPED
    - 10ms任务保存诊断快照到静态变量, 100ms任务读取输出
    - 全有或全无入队, 缓冲区不足整条丢弃+txdrop计数
    - K2/K3事件日志: VEVT,K2,track / VEVT,K3,stop
    - 所有浮点转缩放整数, 无sprintf/阻塞发送/动态内存
2026-07-25 精简视觉调试日志为紧凑60-75字节CSV格式(9600bps兼容蓝牙)
    - 格式: D,seq,age,ok,ir,v,ey,hd,u,l,r,L,R,lp,rp
    - v字段: 压缩视觉状态(mode3bit+transportValid+visionValid+degraded+lr+rr)
    - i字段: 不可驱动原因(NO_TRANSPORT/VISION/MODE/STALE/STOPPED)
    - 200ms日志: Task100ms内部二分频, header只发送一次
    - frameAge>999时日志输出999(实际控制逻辑不受影响)
    - 所有浮点转ToCenti缩放整数, 无浮点printf
    - VisionTrack_GetInvalidReason统一10ms控制和100ms日志判断
    - 缓冲不足整条丢弃, 不发送半条日志
    - UART1 9600 8N1非阻塞发送
2026-07-25 优化视觉弯道循迹与蓝牙调试日志
2026-07-25 稳定视觉急弯转向与低速轮速控制
2026-07-26 优化视觉急弯预瞄与转向稳定性
2026-07-26 修正视觉预瞄方向与曲线反向放行
2026-07-26 减弱深弯大误差转向修正
2026-07-26 适配后视摄像头十厘米控制几何
2026-07-26 fix: align rear-mode forward with camera view
    [Board_Config.h]
2026-07-26 fix: correct visual turn direction for rear camera
    [app_vision_track.h]
2026-07-26 tune: extend visual preview distance to 150mm
2026-07-26 fix: smooth rear-camera visual curve control
    [Board_Config.h, app_vision_track.c, app_vision_track.h]
2026-07-26 tune: shorten curve reversal confirmation
    [app_vision_track.h]
2026-07-28 migrate JY61P serial from UART0 PA0/PA1 to UART2 PA23/PA24 (withoutK230 master_car)
2026-07-28 JY61P diag: add UART2 IRQ stats, raw trace, 3-page output, reset cause, fault classification, stack 256->1024
    [JY61P.c, JY61P.h, Serial.c, Serial.h, app_board_test.c, app_config.h]
2026-07-28 migrate JY61P driver to withK230 master_car: add UART2 (PA23/PA24), JY61P_Serial, 3-page diag, stack 256->1024
2026-07-28 fix: harden cleaned withK230 master base
    [app_board_test.c, app_config.h, app_radio.c, app_radio.h, main.c]
2026-07-29 feat: add dc motor encoder board test
2026-07-29 fix: correct motor direction and move k4 to pa29
    [Board_Config.h, ti_msp_dl_config.h]
2026-07-29 新增任务状态机
2026-07-29 feat: add rod stepper board test
2026-07-29 feat: route K230 through UART1
2026-07-29 fix: move grayscale AD1 to PB11
    [Board_Config.h, Grayscale.c, ti_msp_dl_config.h]
2026-07-29 feat: set rod jog angle to 18 degrees
2026-07-29 feat: set rod jog angle to 72 degrees
2026-07-29 refactor: remove rod stepper test safety guards
2026-07-29 feat: set rod soft limit to 3096 counts
2026-07-29 fix: harden H26 task 3 closed loop
    [DebugSerial.c, app_ball_link.c, app_ball_link.h, app_h26.c, app_h26_config.h, app_h26_task3.c, app_h26_task3.h]
2026-07-30 fix: tune H26 task controls
    [Board_Config.h, app_board_test.c, app_car_state.c, app_config.h, app_h26.c, app_h26_ball_control.c, app_h26_config.h, app_h26_task2.c]
2026-07-31 新增H题目任务状态机
2026-07-31 任务五能跑通的初版V1
2026-07-31 feat: split task5 ball PID gains by path
2026-08-01 fix: set Task5 drive target compensation to 0; tune Task2/Task3 params; add line-lost turn recovery
    [app_h26.c, app_h26_ball_control.c, app_h26_ball_control.h, app_h26_config.h, app_h26_task2.c, app_h26_task3.c, app_h26_task3.h, app_h26_task4.c]
2026-08-01 feat: add Task6 multi-position dynamic hold with distance-scheduled PID/compensation/FF; align Task4 to share Task6 framework with 35cm/s straight speed
